mookiedog/ApriliaGen1ECU/ECU_s1.png

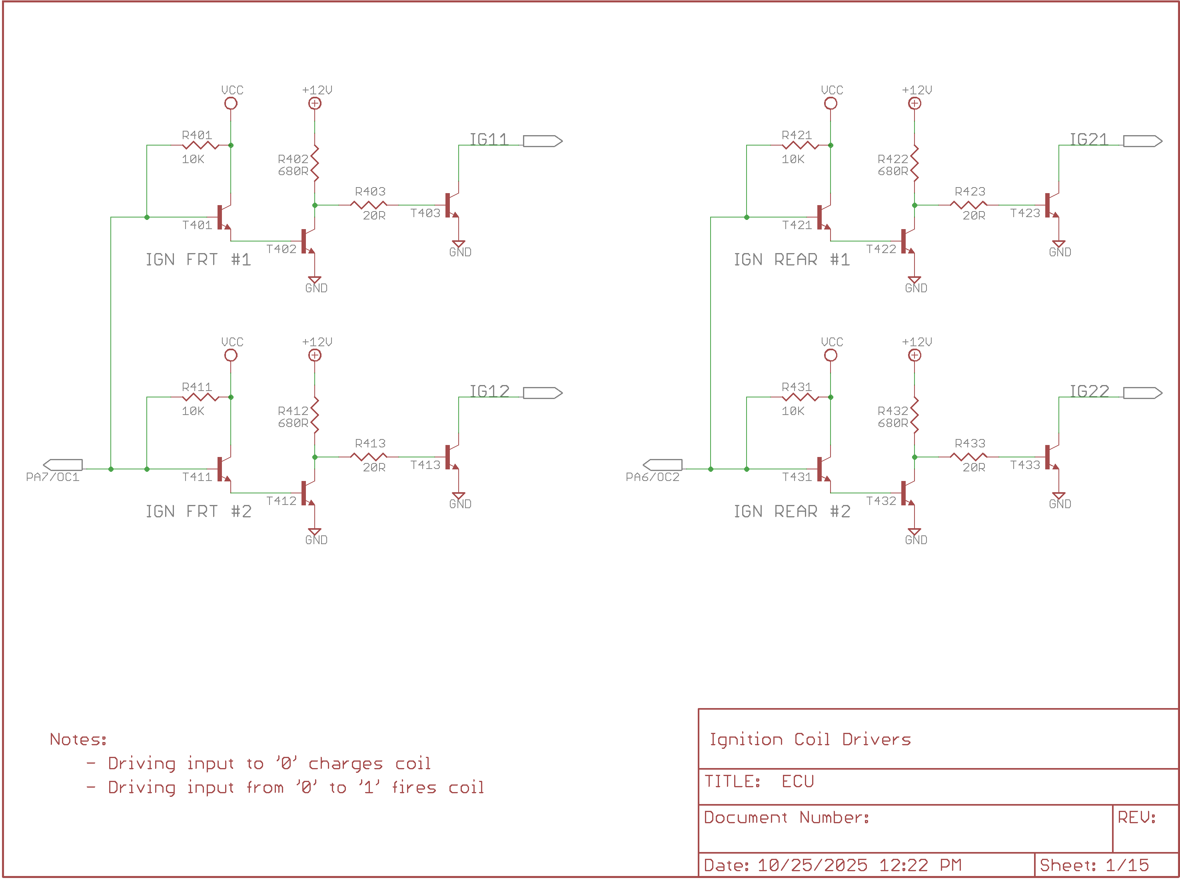
ECU_s1.png
