mookiedog/ApriliaGen1ECU/ECU_s2.png

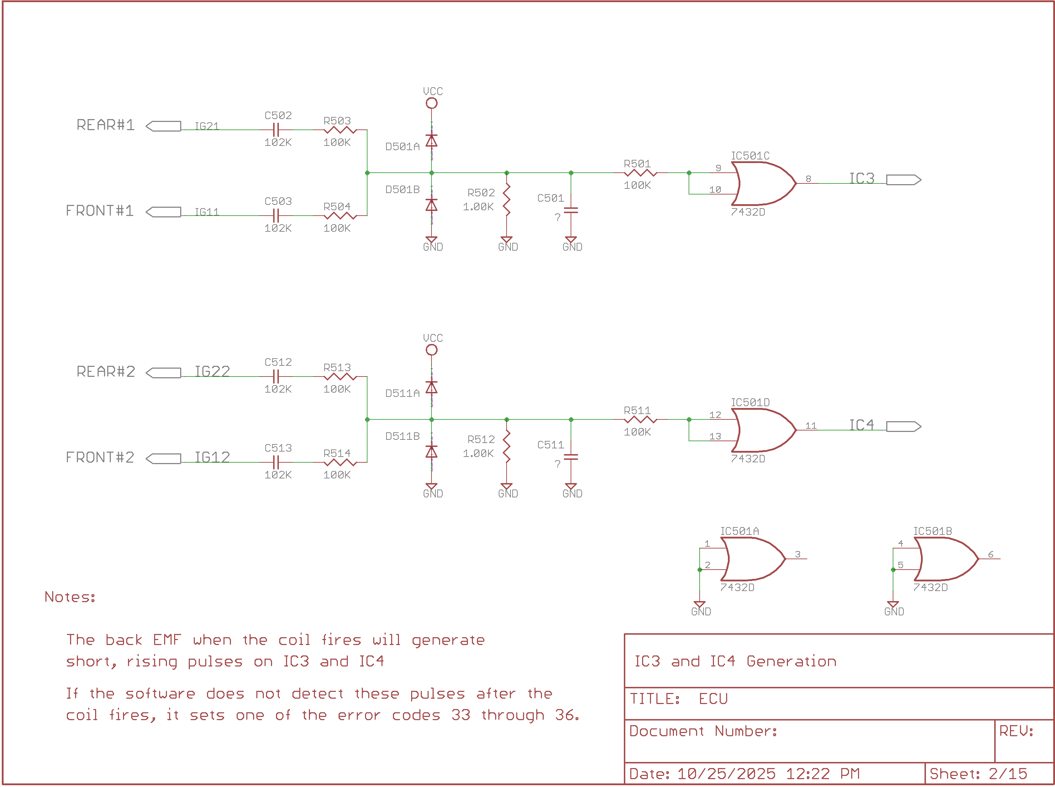
ECU_s2.png
