mookiedog/ApriliaGen1ECU/ECU_s3.png

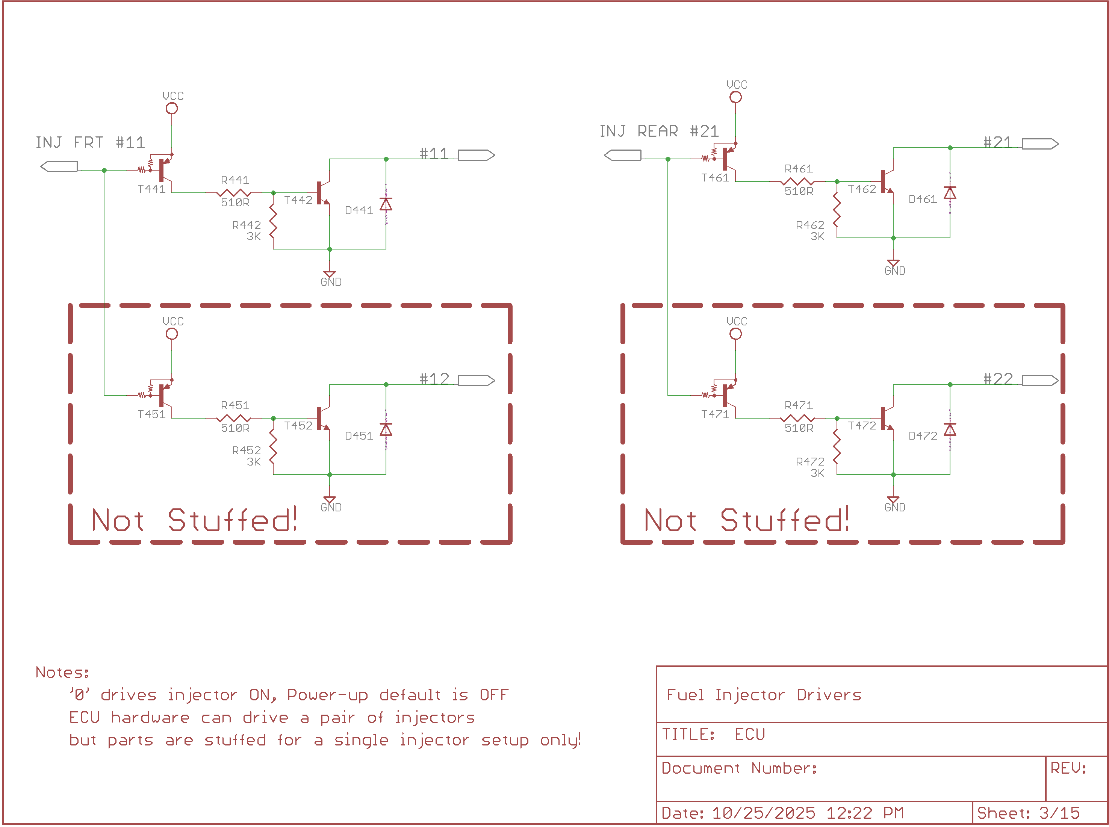
ECU_s3.png
