mookiedog/ApriliaGen1ECU/ECU_s4.png

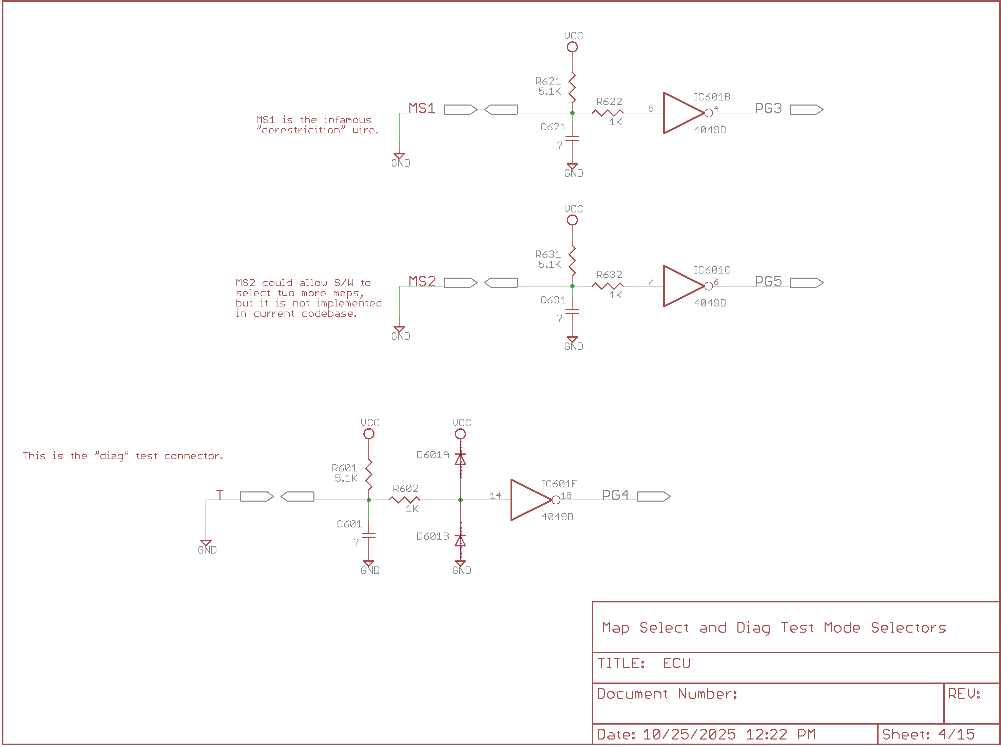
ECU_s4.png
