mookiedog/ApriliaGen1ECU/ECU_s5.png

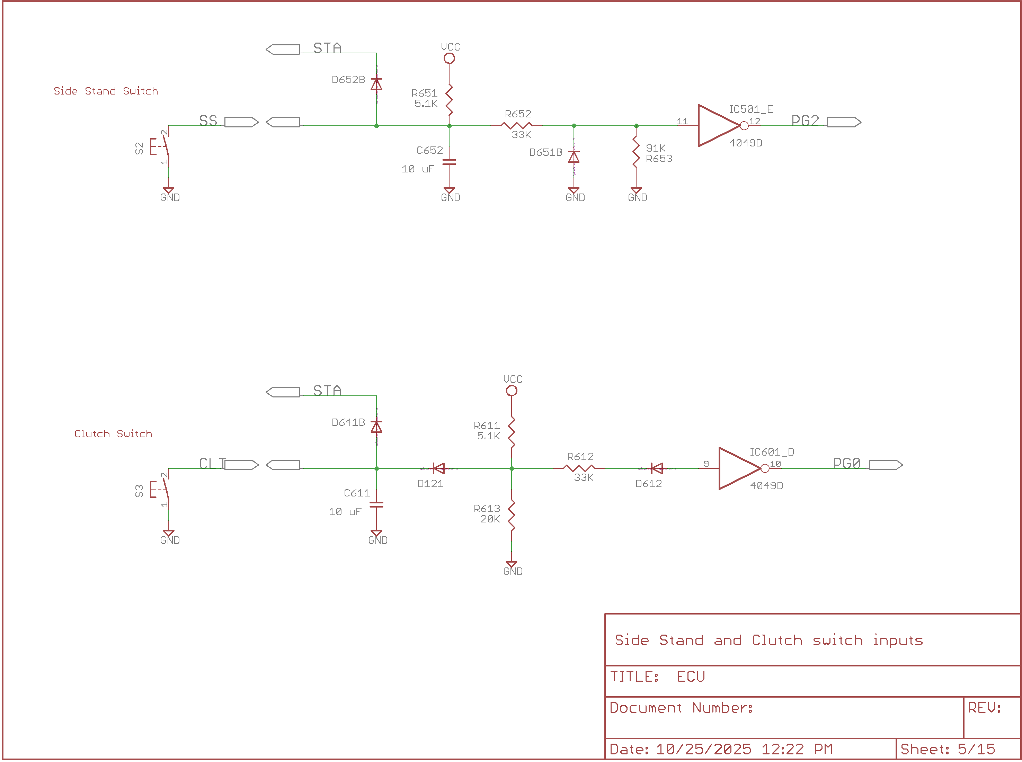
ECU_s5.png
