mookiedog/ApriliaGen1ECU/ECU_s6.png

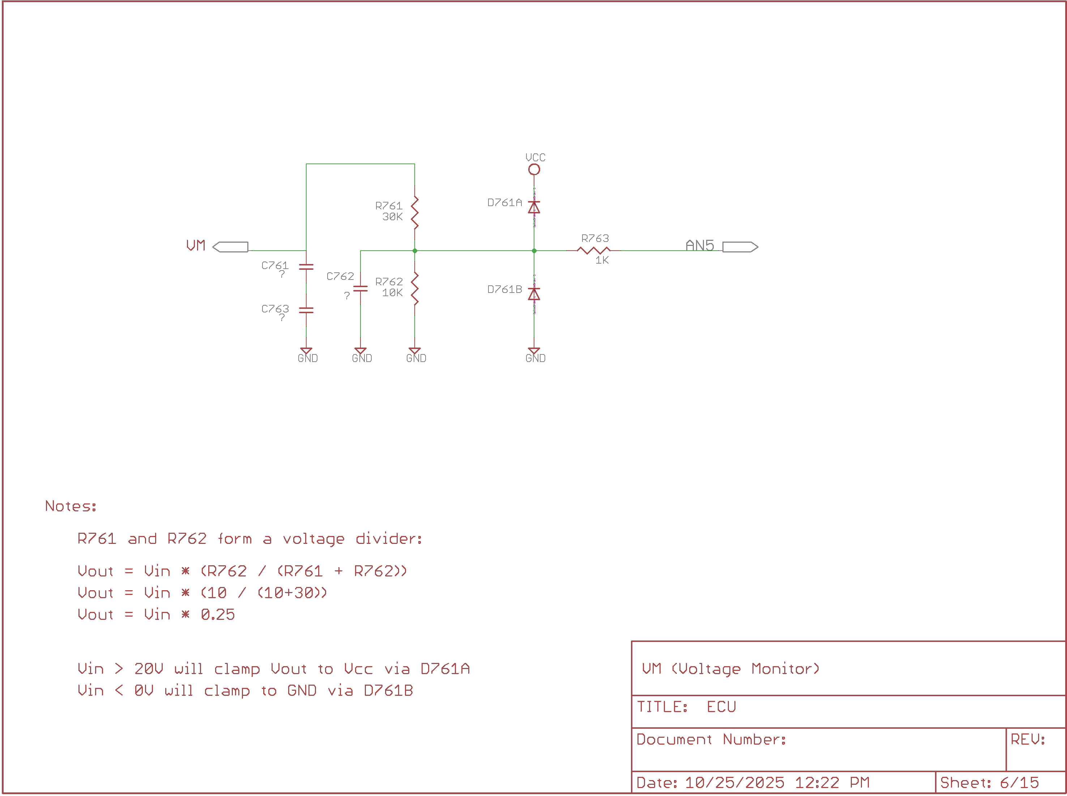
ECU_s6.png
