mookiedog/ApriliaGen1ECU/ECU_s7.png

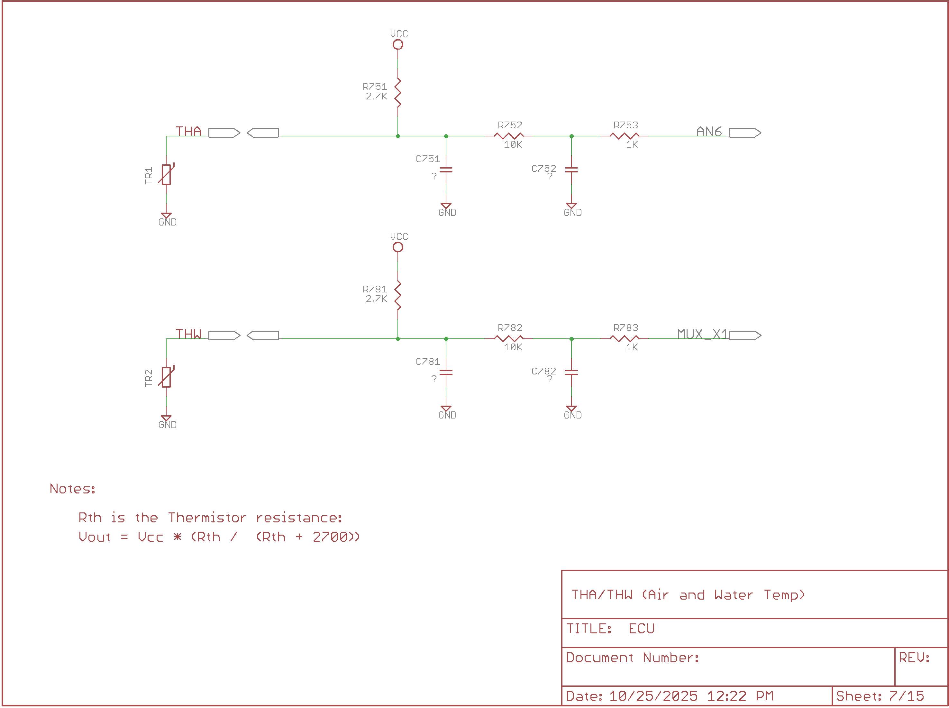
ECU_s7.png
