mookiedog/ApriliaGen1ECU/ECU_s8.png

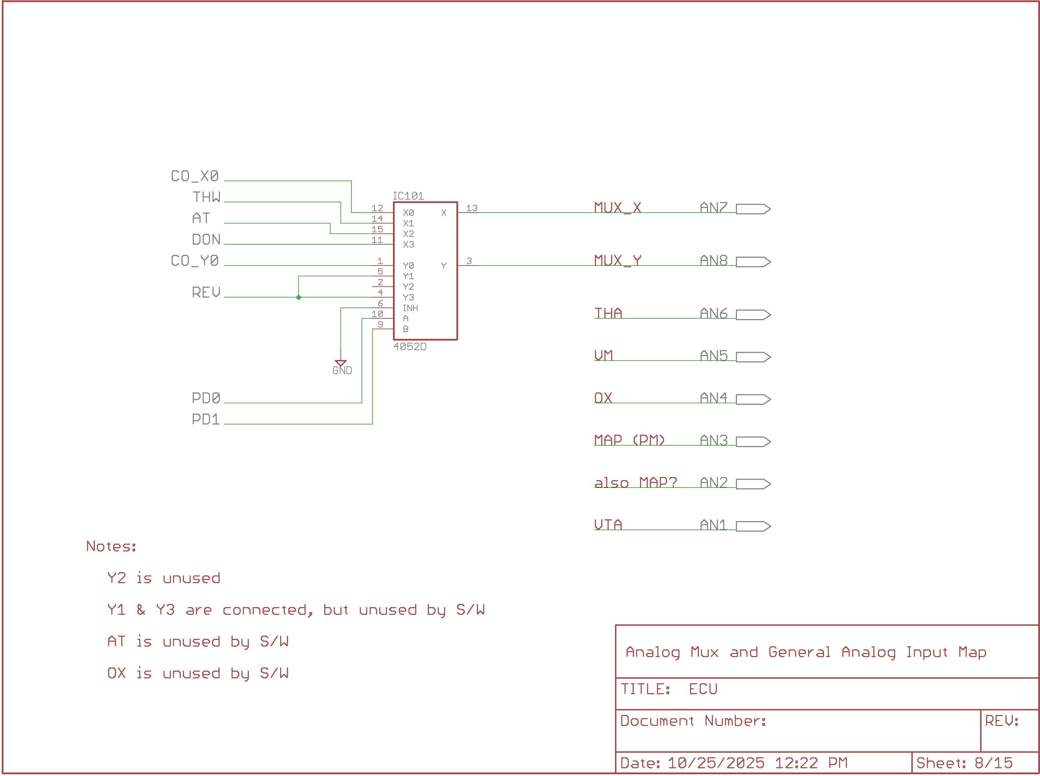
ECU_s8.png
