mookiedog/ApriliaGen1ECU/ECU_s9.png

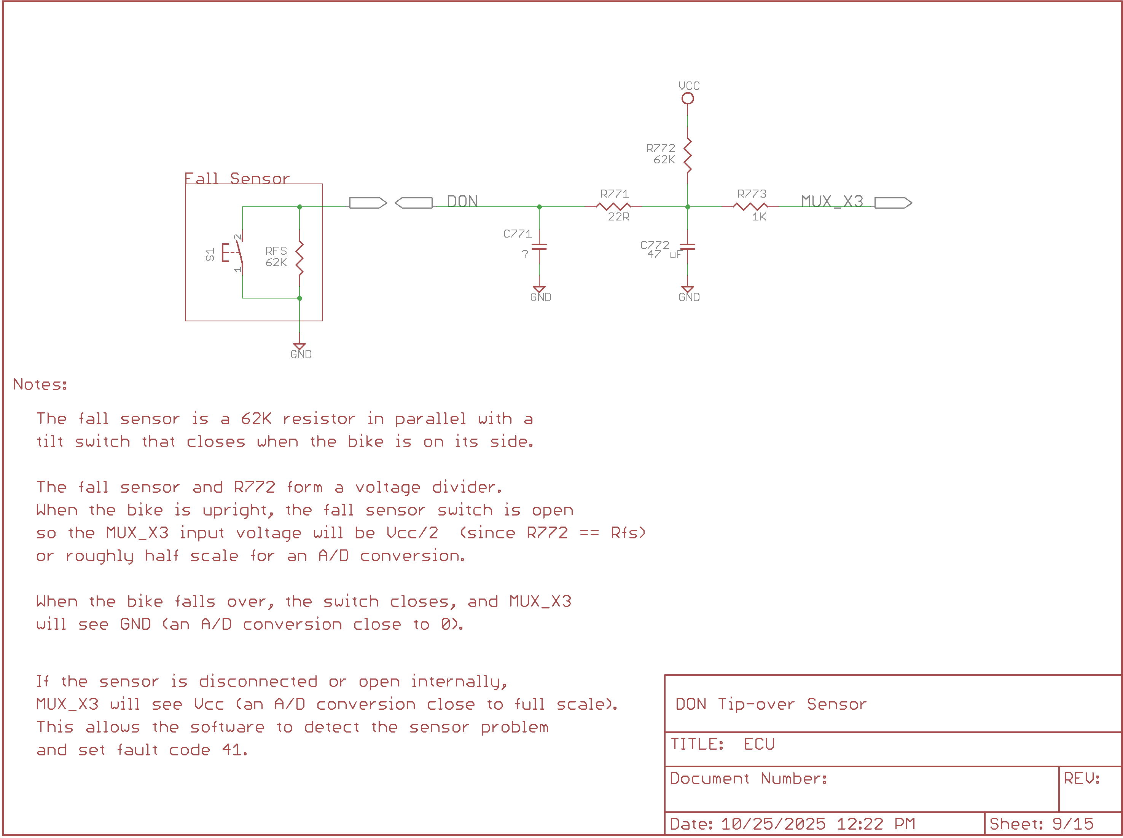
ECU_s9.png
