mookiedog/ApriliaGen1ECU/ECU_s10.png

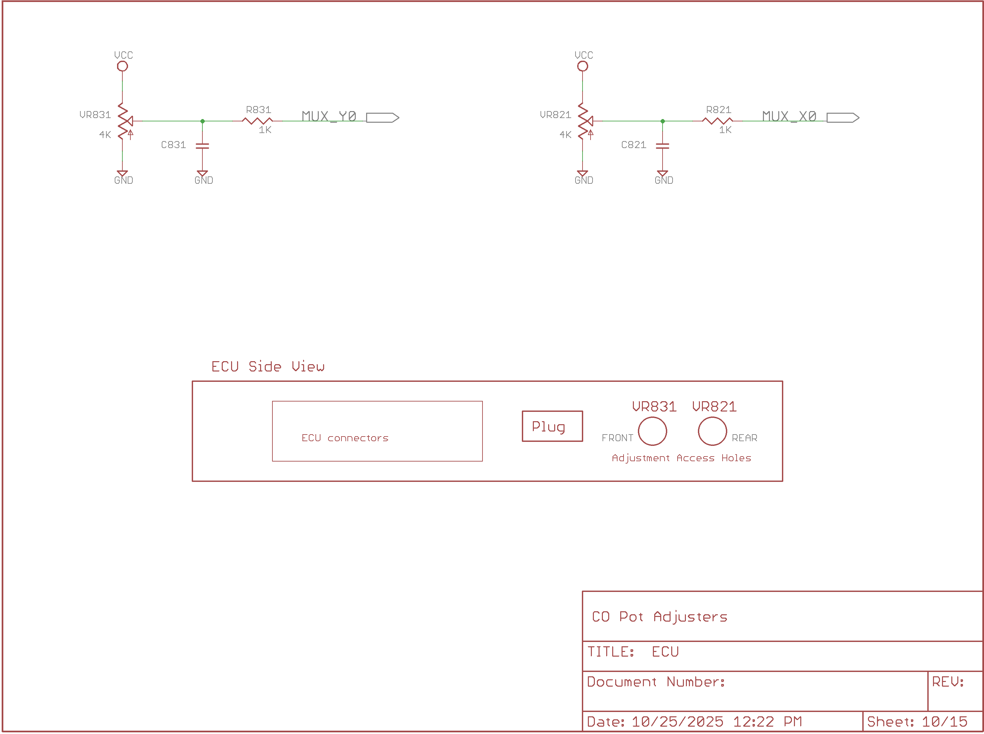
ECU_s10.png
