mookiedog/ApriliaGen1ECU/ECU_s11.png

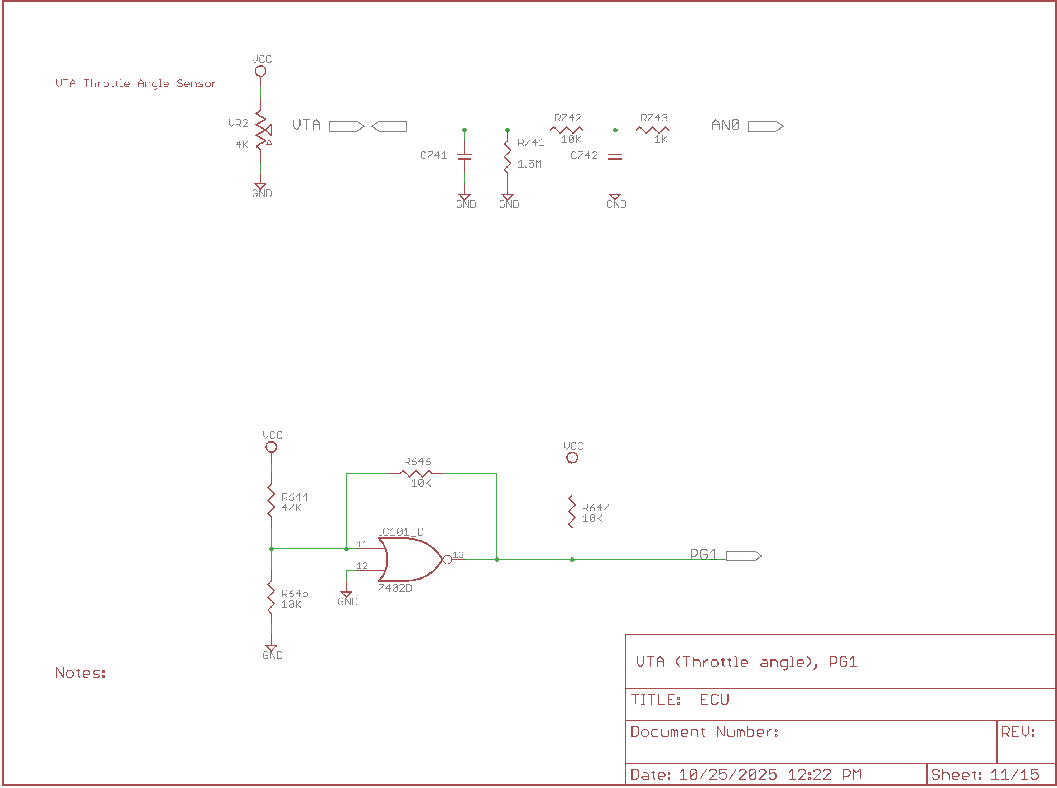
ECU_s11.png
