mookiedog/ApriliaGen1ECU/ECU_s12.png

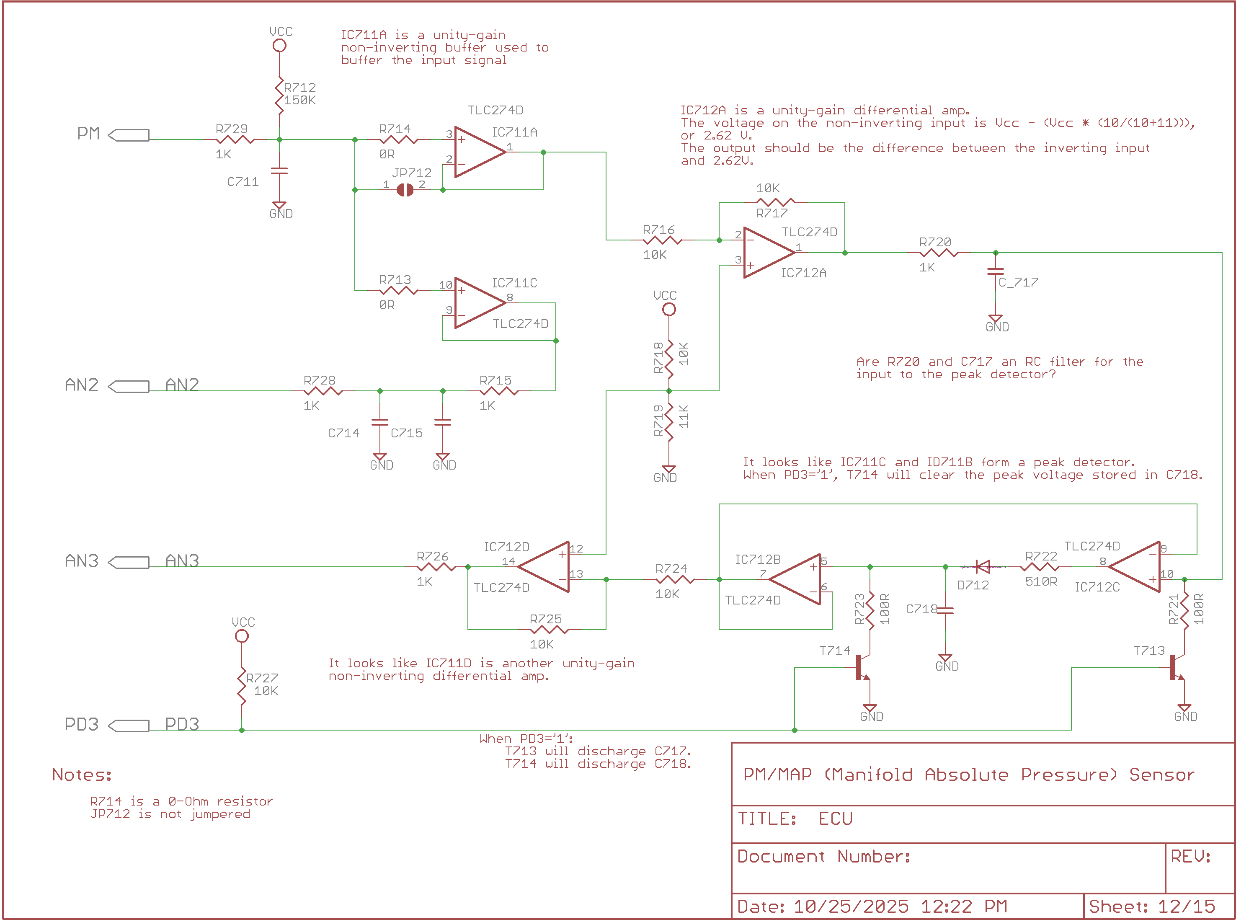
ECU_s12.png
