mookiedog/ApriliaGen1ECU/ECU_s13.png

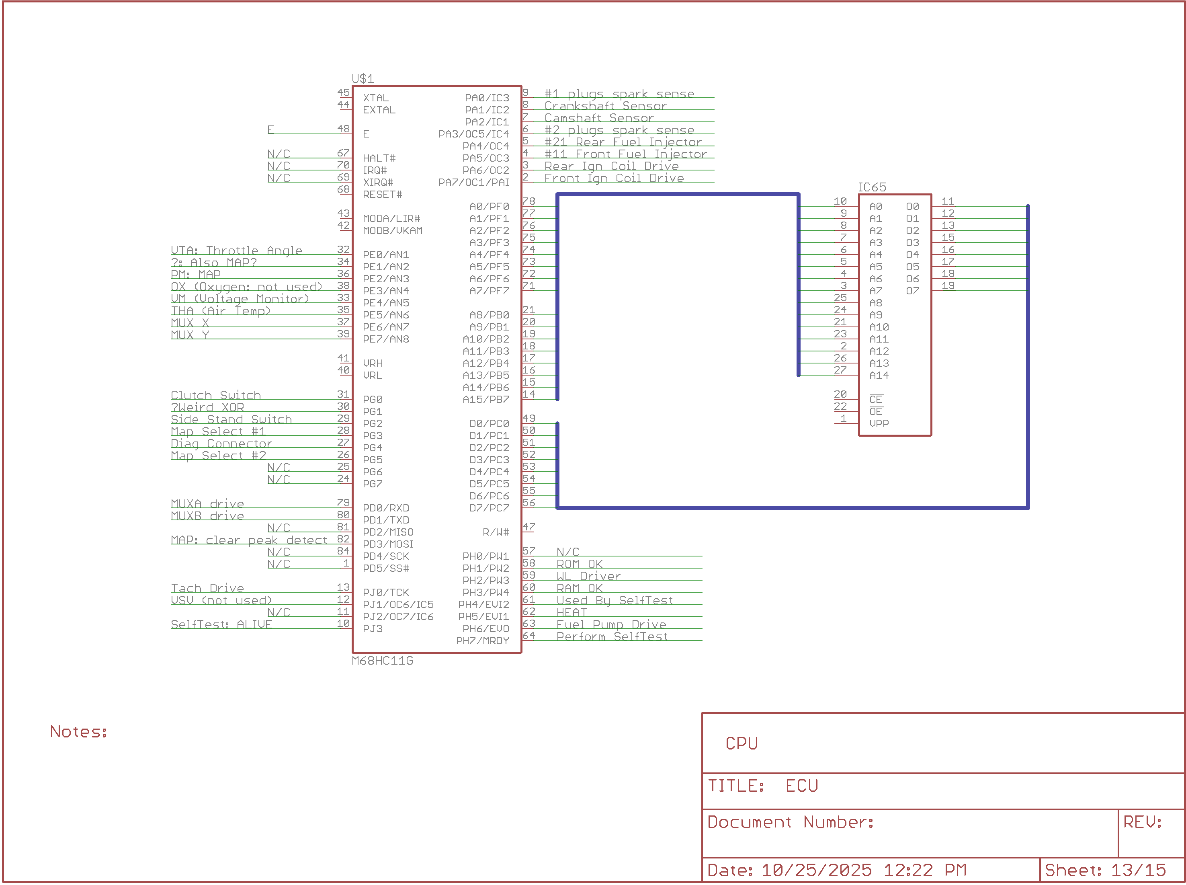
ECU_s13.png
