mookiedog/ApriliaGen1ECU/ECU_s14.png

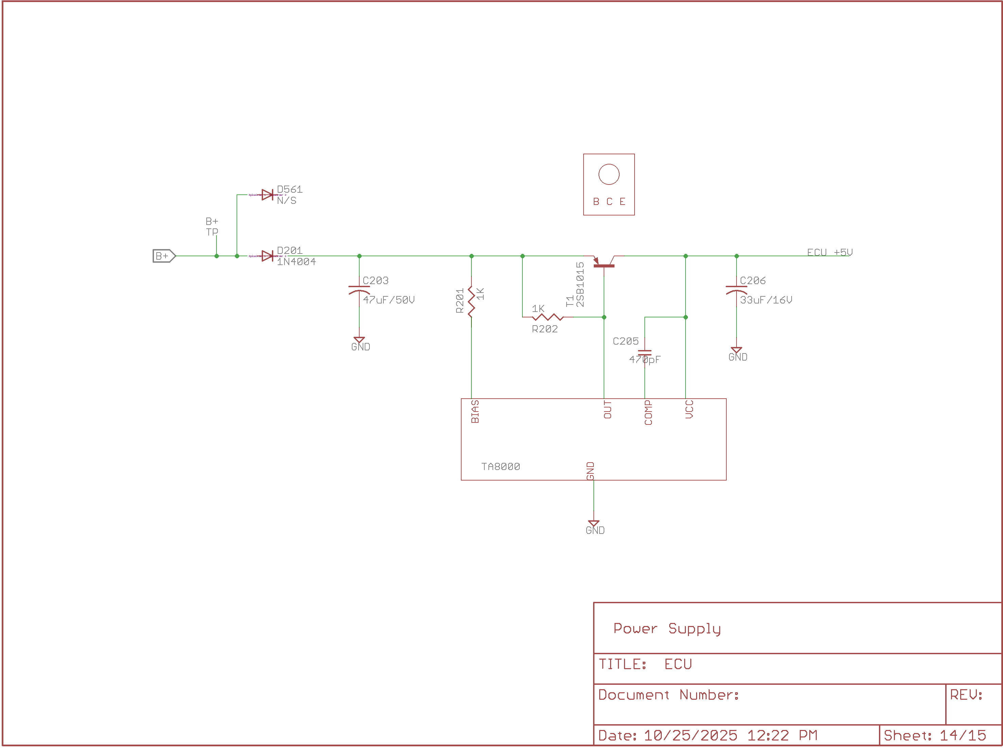
ECU_s14.png
