mookiedog/ApriliaGen1ECU/ECU_s15.png

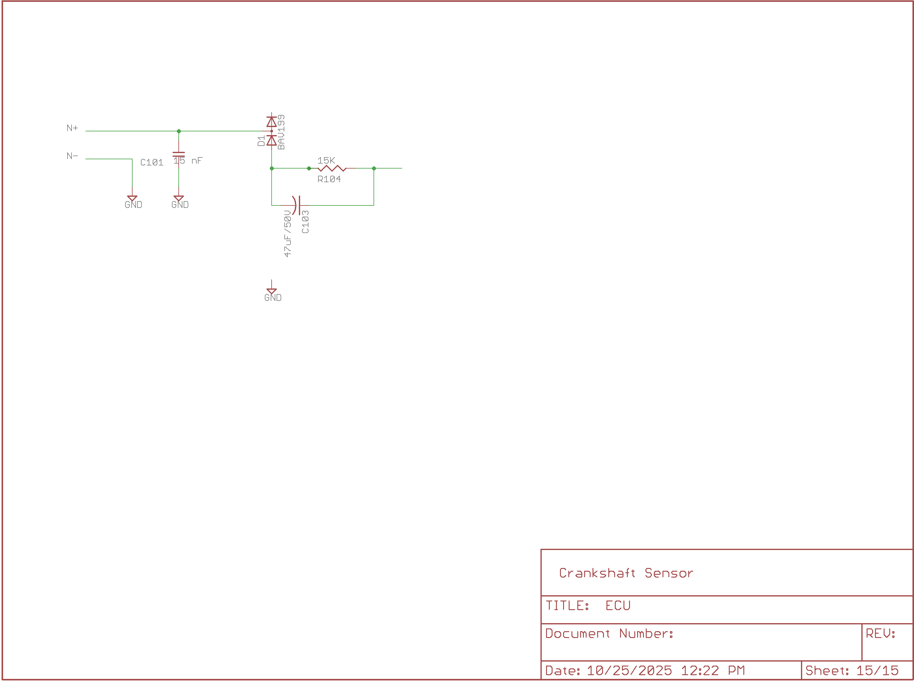
ECU_s15.png
