mookiedog/ApriliaGen1ECU/ECU.sch

## EAGLE design ECU.sch (2025-10-27)

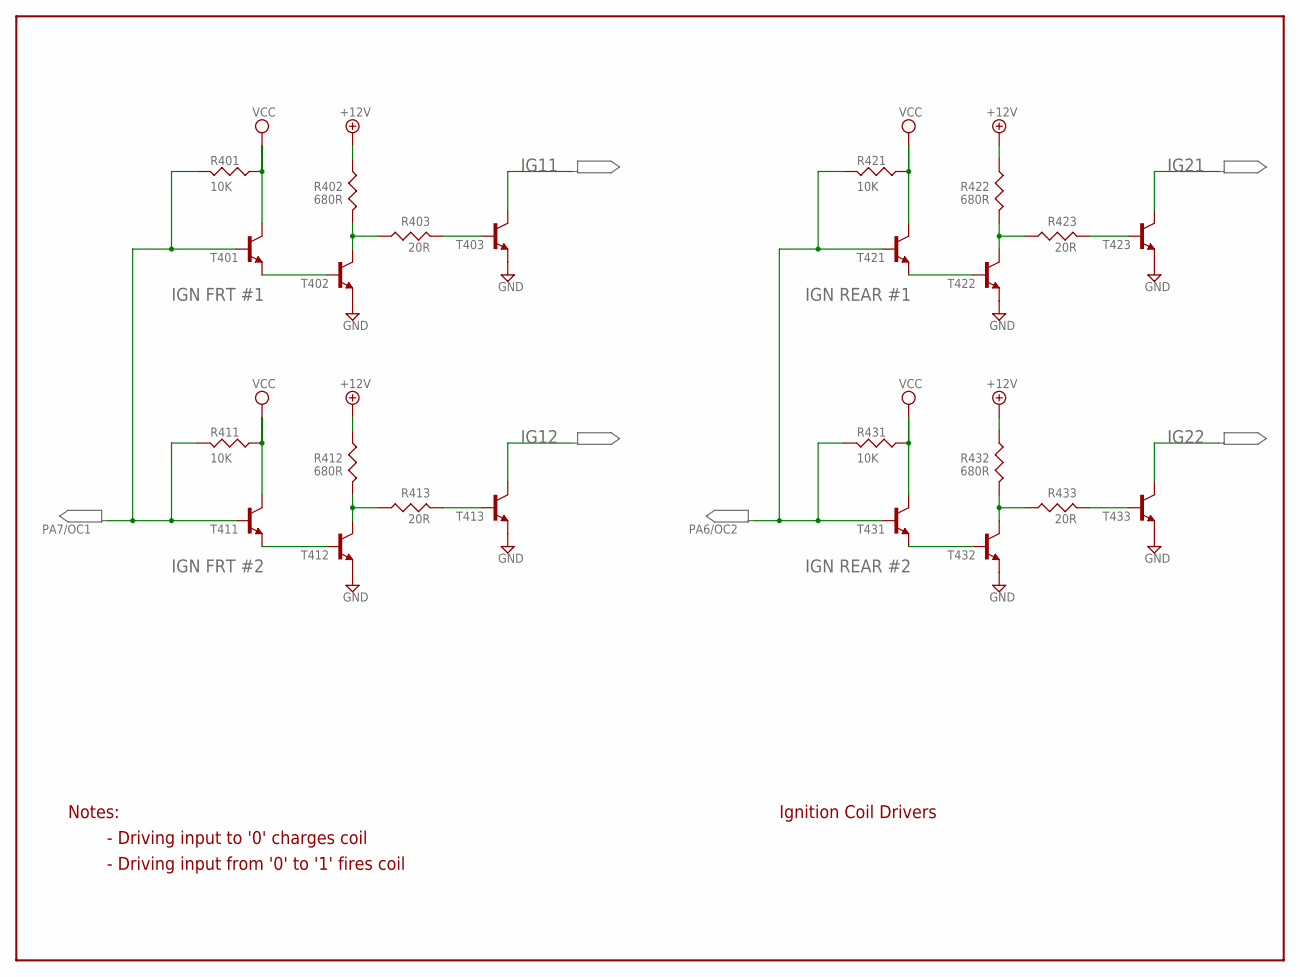
[picture p16: schematic ECU.sch, sheet 1]

Parts:
R401, R411, R421, R431: 10K; R-5
R402, R412, R422, R432: 680R; R-5
R403, R413, R423, R433: 20R; R-5
T401, T402, T403, T411, T412, T413, T421, T422, T423, T431, T432, T433: BCF32SMD; SOT23-BEC

Connections:
+12V: R402.1, R412.1, R422.1, R432.1
GND: T402.E, T403.E, T412.E, T413.E, T422.E, T423.E, T432.E, T433.E
IG11: T403.C
IG12: T413.C
IG21: T423.C
IG22: T433.C
unnamed: R402.2, R403.1, T402.C
unnamed: T401.E, T402.B
unnamed: R401.2, R411.2, T401.B, T411.B
unnamed: R403.2, T403.B
unnamed: T421.E, T422.B
unnamed: R422.2, R423.1, T422.C
unnamed: R423.2, T423.B
unnamed: R421.2, R431.2, T421.B, T431.B
unnamed: T411.E, T412.B
unnamed: R412.2, R413.1, T412.C
unnamed: R413.2, T413.B
unnamed: T431.E, T432.B
unnamed: R432.2, R433.1, T432.C
unnamed: R433.2, T433.B
VCC: R401.1, R411.1, R421.1, R431.1, T401.C, T411.C, T421.C, T431.C

Notes on the sheet:
Ignition Coil Drivers
IGN FRT #1
IGN REAR #1
IGN FRT #2
IGN REAR #2
Notes:
- Driving input to '0' charges coil
- Driving input from '0' to '1' fires coil
PA7/OC1
PA6/OC2

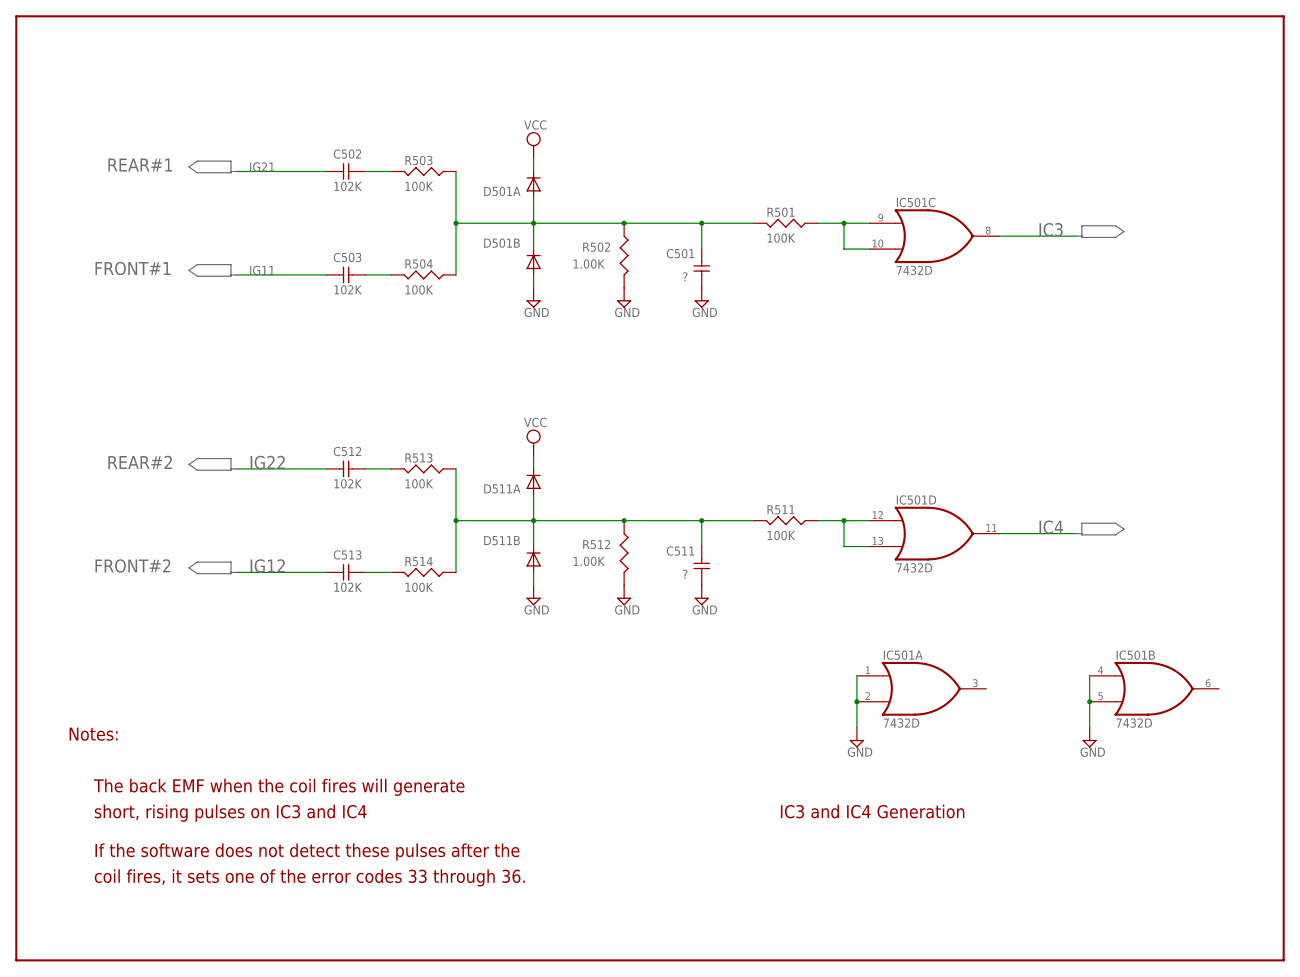
[picture p17: schematic ECU.sch, sheet 2]

Parts:
C501, C511: ?; C-2,5
C502, C503, C512, C513: 102K; C-2,5
D501A, D501B, D511A, D511B: 1N4004; DO41-10
IC501: 7432D; SO14
R501, R503, R504, R511, R513, R514: 100K; R-5
R502, R512: 1.00K; R-5

Connections:
GND: C501.1, C511.1, D501B.A, D511B.A, IC501.1 (I0), IC501.2 (I1), IC501.4 (I0), IC501.5 (I1), R502.2, R512.2
IC3: IC501.8 (O)
IC4: IC501.11 (O)
IG11: C503.1
IG12: C513.1
IG21: C502.1
IG22: C512.1
unnamed: C503.2, R504.2
unnamed: C501.2, D501A.A, D501B.C, R501.2, R502.1, R503.1, R504.1
unnamed: IC501.9 (I0), IC501.10 (I1), R501.1
unnamed: C502.2, R503.2
unnamed: C512.2, R513.2
unnamed: C513.2, R514.2
unnamed: C511.2, D511A.A, D511B.C, R511.2, R512.1, R513.1, R514.1
unnamed: IC501.12 (I0), IC501.13 (I1), R511.1
VCC: D501A.C, D511A.C

Notes on the sheet:
IC3 and IC4 Generation
FRONT#1
REAR#1
REAR#2
FRONT#2
The back EMF when the coil fires will generate
short, rising pulses on IC3 and IC4
Notes:
If the software does not detect these pulses after the
coil fires, it sets one of the error codes 33 through 36.

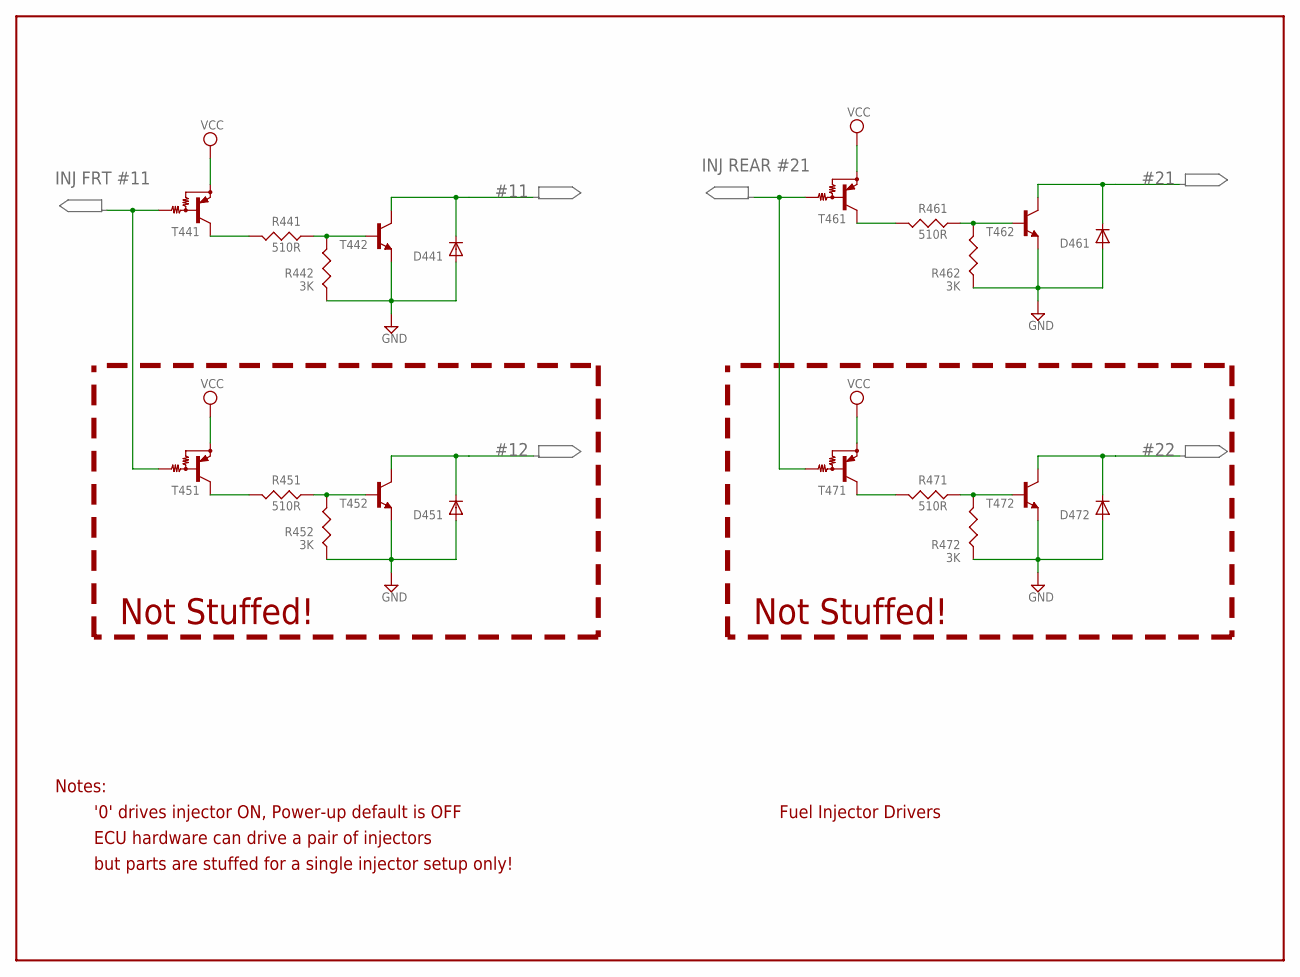
[picture p18: schematic ECU.sch, sheet 3]

Parts:
D441, D451, D461, D472: 1N4004; DO41-10
R441, R451, R461, R471: 510R; R-5
R442, R452, R462, R472: 3K; R-5
T441, T451, T461, T471: MUN2111T1-PNP_DRIVER-SC59-BEC; SC59-BEC
T442, T452, T462, T472: BCF32SMD; SOT23-BEC

Connections:
GND: D441.A, D451.A, D461.A, D472.A, R442.1, R452.1, R462.1, R472.1, T442.E, T452.E, T462.E, T472.E
unnamed: R441.2, T441.C
unnamed: D441.C, T442.C
unnamed: D461.C, T462.C
unnamed: D472.C, T472.C
unnamed: R461.2, T461.C
unnamed: R461.1, R462.2, T462.B
unnamed: D451.C, T452.C
unnamed: T441.B, T451.B
unnamed: R451.2, T451.C
unnamed: R451.1, R452.2, T452.B
unnamed: T461.B, T471.B
unnamed: R471.2, T471.C
unnamed: R471.1, R472.2, T472.B
unnamed: R441.1, R442.2, T442.B
VCC: T441.E, T451.E, T461.E, T471.E

Notes on the sheet:
Fuel Injector Drivers
INJ FRT #11
INJ REAR #21
Not Stuffed!
Notes:
ECU hardware can drive a pair of injectors
but parts are stuffed for a single injector setup only!
'0' drives injector ON, Power-up default is OFF

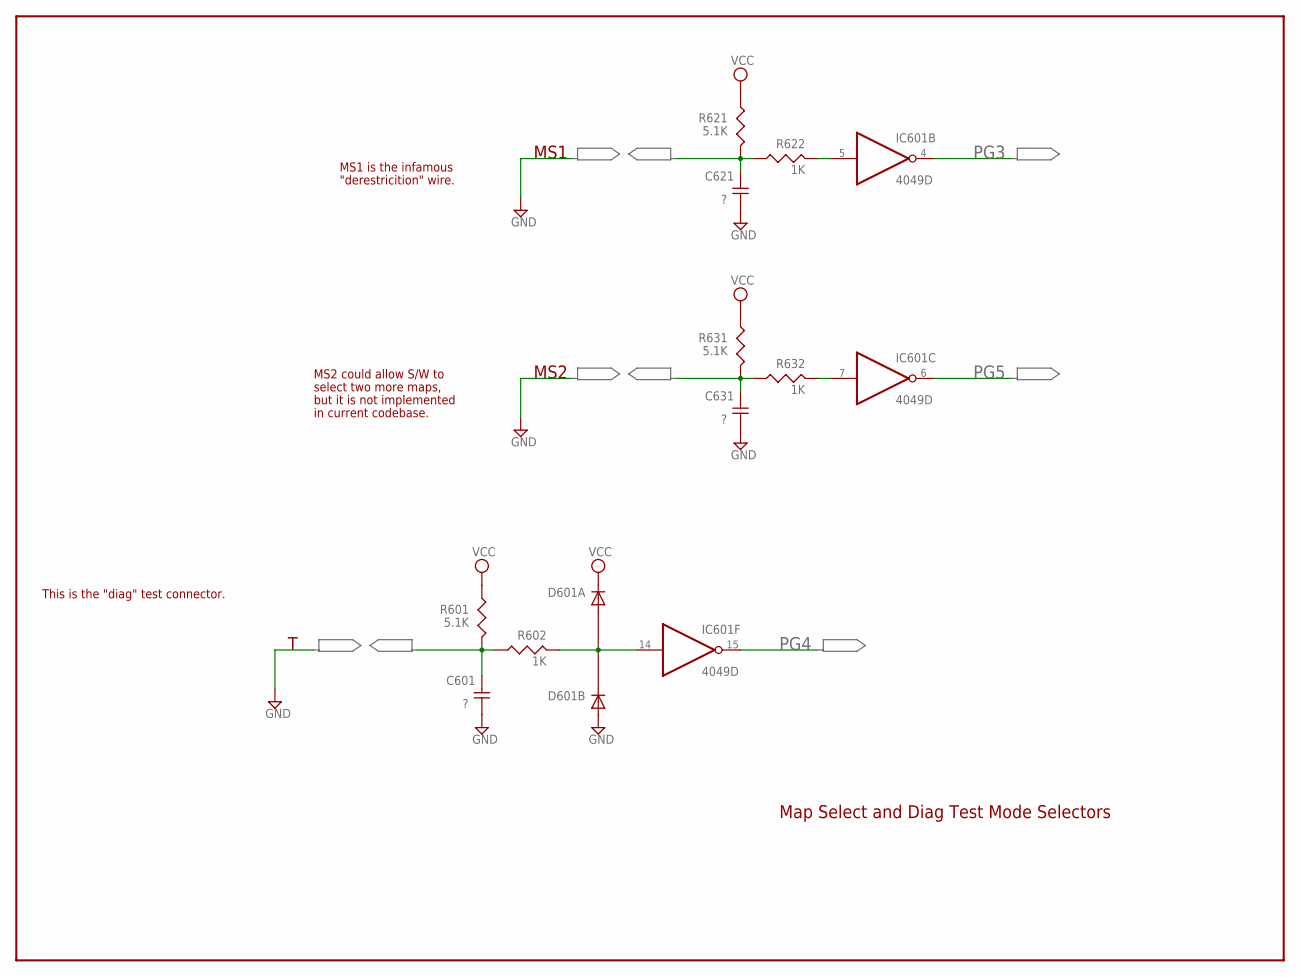
[picture p19: schematic ECU.sch, sheet 4]

Parts:
C601, C621, C631: ?; C-2,5
D601A, D601B: 1N4004; DO41-10
IC601: 4049D; SO16
R601, R621, R631: 5.1K; R-5
R602, R622, R632: 1K; R-5

Connections:
GND: C601.1, C621.1, C631.1, D601B.A
unnamed: C621.2, R621.2, R622.1
unnamed: IC601.5 (I), R622.2
unnamed: C631.2, R631.2, R632.1
unnamed: IC601.7 (I), R632.2
unnamed: C601.2, R601.2, R602.1
unnamed: IC601.14 (I), R602.2
PG3: IC601.4 (O)
PG4: IC601.15 (O)
PG5: IC601.6 (O)
VCC: D601A.C, R601.1, R621.1, R631.1

Notes on the sheet:
Map Select and Diag Test Mode Selectors
MS1
MS2
MS1 is the infamous
"derestricition" wire.
MS2 could allow S/W to
select two more maps,
but it is not implemented
in current codebase.
This is the "diag" test connector.

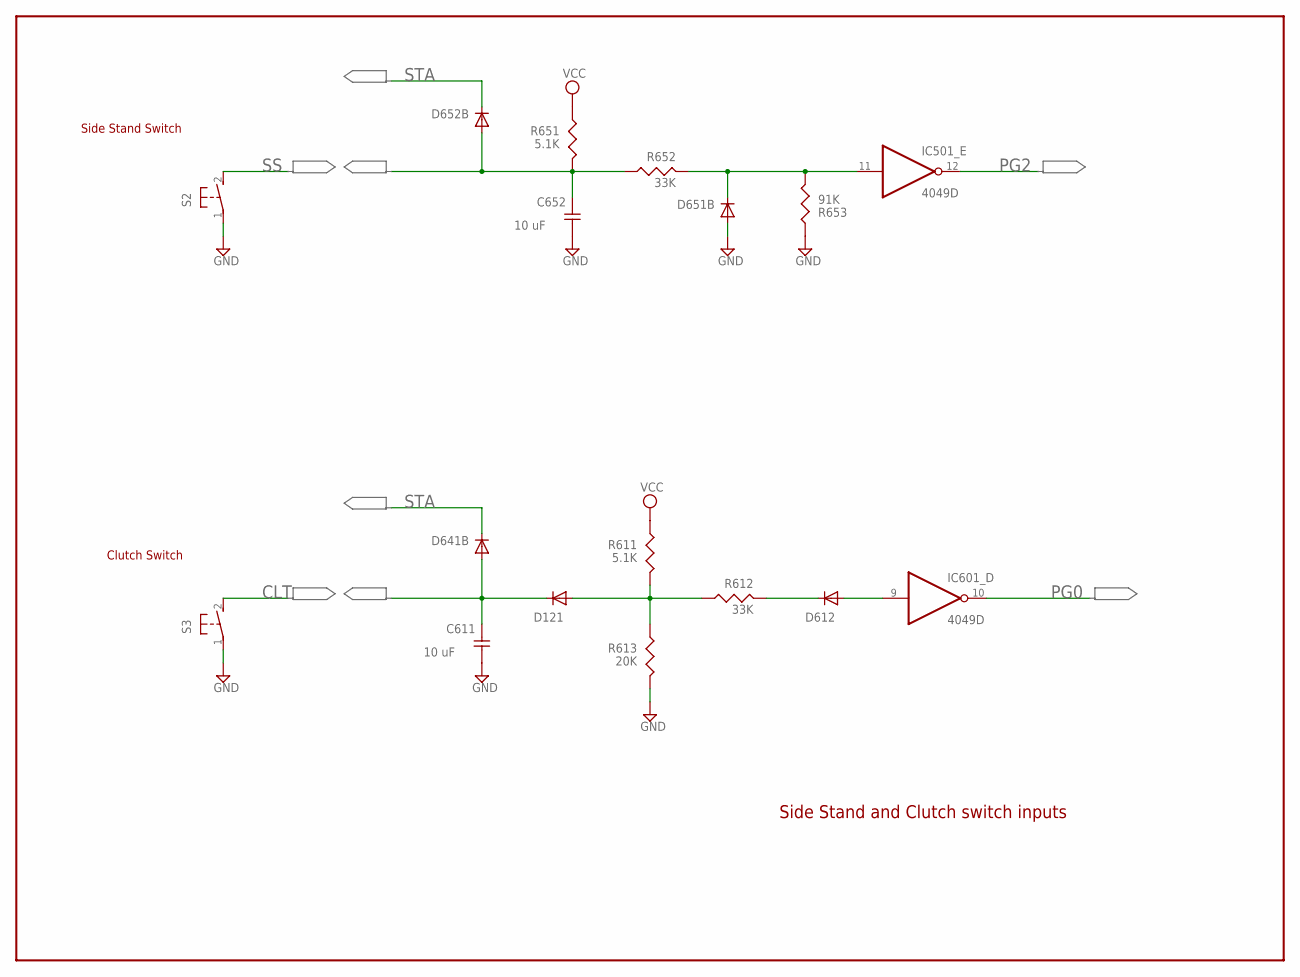
[picture p20: schematic ECU.sch, sheet 5]

Parts:
C611, C652: 10 uF; C-2,5
D121, D612, D641B, D651B, D652B: 1N4004; DO41-10
IC501_, IC601_: 4049D; SO16
R611, R651: 5.1K; R-5
R612, R652: 33K; R-5
R613: 20K; R-5
R653: 91K; R-5
S2, S3: 31-XX; B3F-31XX

Connections:
CLT: S3.2 (S)
GND: C611.1, C652.1, D651B.A, R613.2, R653.1, S2.1, S3.1
unnamed: C652.2, D652B.A, R651.2, R652.1
unnamed: D651B.C, IC501_.11 (I), R652.2, R653.2
unnamed: C611.2, D121.C, D641B.A
unnamed: D612.C, R612.2
unnamed: D612.A, IC601_.9 (I)
unnamed: D121.A, R611.2, R612.1, R613.1
PG0: IC601_.10 (O)
PG2: IC501_.12 (O)
SS: S2.2 (S)
STA: D641B.C, D652B.C
VCC: R611.1, R651.1

Notes on the sheet:
Side Stand and Clutch switch inputs
Side Stand Switch
Clutch Switch

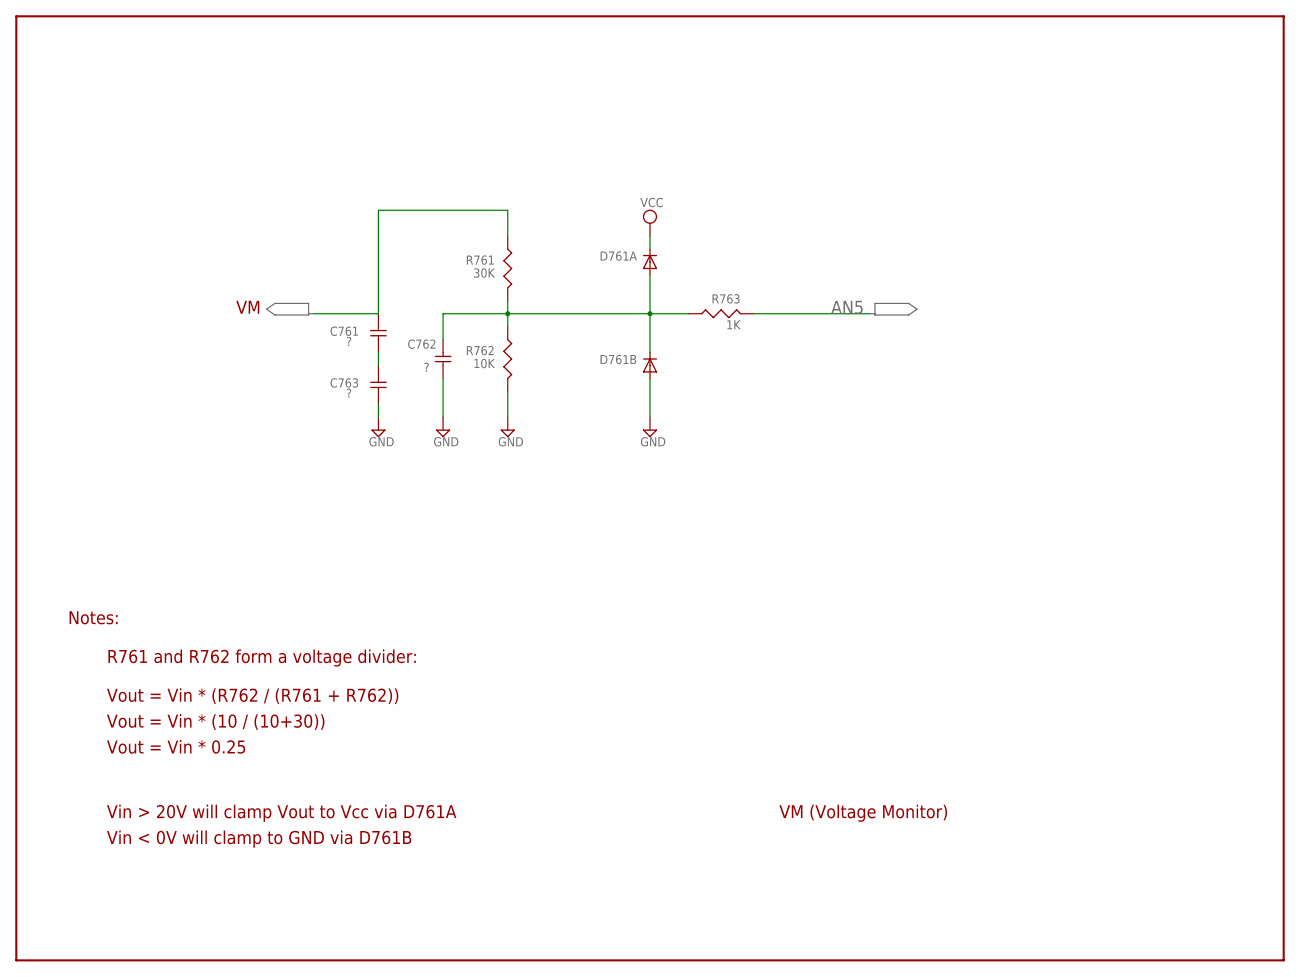
[picture p21: schematic ECU.sch, sheet 6]

Parts:
C761, C762, C763: ?; C-2,5
D761A, D761B: 1N4004; DO41-10
R761: 30K; R-5
R762: 10K; R-5
R763: 1K; R-5

Connections:
AN5: R763.2
GND: C762.1, C763.1, D761B.A, R762.2
unnamed: C761.1, C763.2
unnamed: C762.2, D761A.A, D761B.C, R761.2, R762.1, R763.1
unnamed: C761.2, R761.1
VCC: D761A.C

Notes on the sheet:
VM (Voltage Monitor)
Notes:
R761 and R762 form a voltage divider:
Vout = Vin * (R762 / (R761 + R762))
Vout = Vin * (10 / (10+30))
Vout = Vin * 0.25
Vin > 20V will clamp Vout to Vcc via D761A
Vin < 0V will clamp to GND via D761B

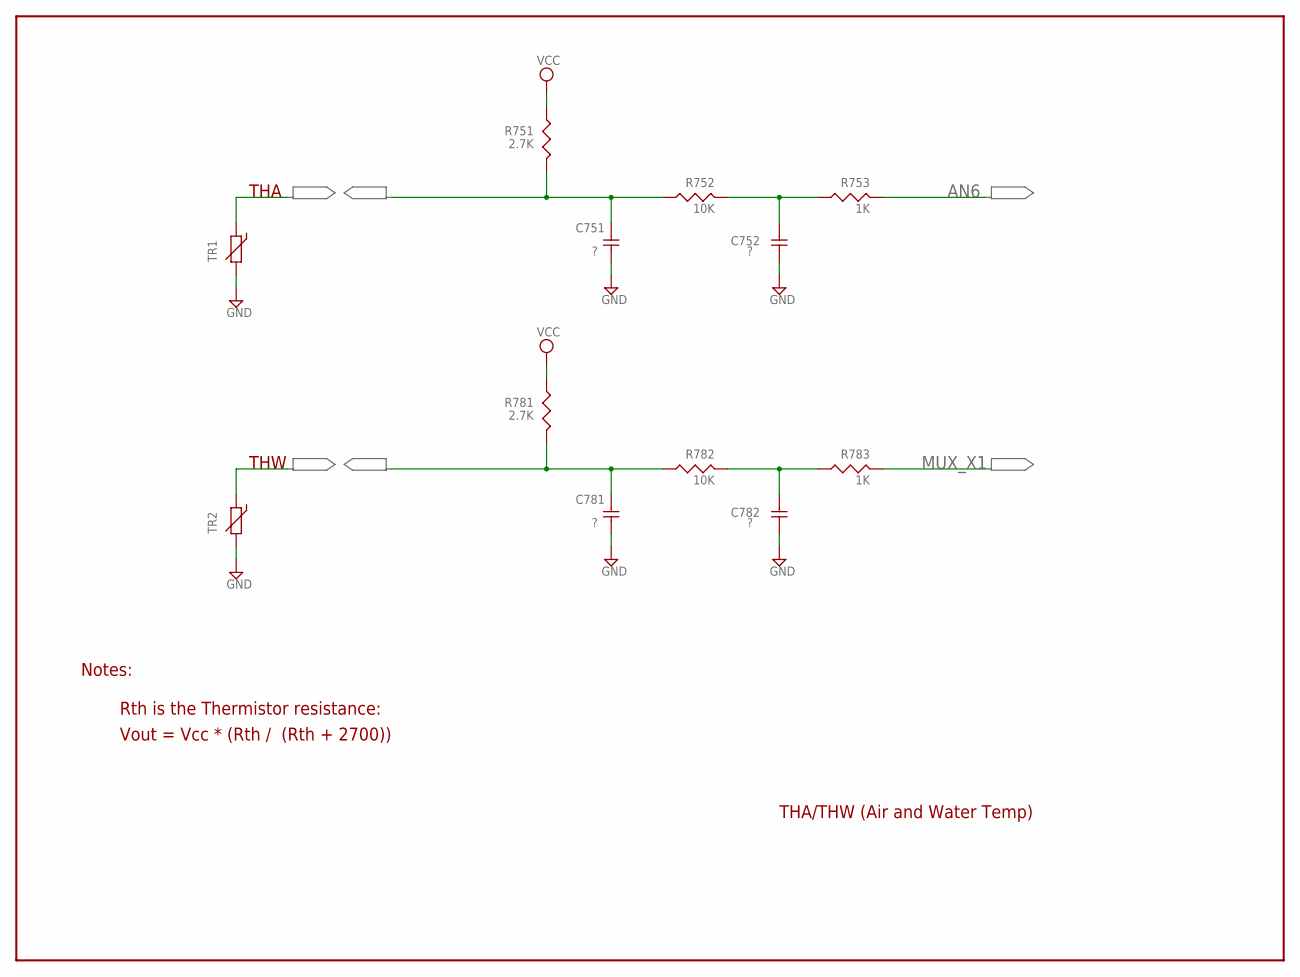
[picture p22: schematic ECU.sch, sheet 7]

Parts:
C751, C752, C781, C782: ?; C-2,5
R751, R781: 2.7K; R-5
R752, R782: 10K; R-5
R753, R783: 1K; R-5
TR1, TR2: THERM-5; R-5

Connections:
AN6: R753.2
GND: C751.1, C752.1, C781.1, C782.1, TR1.2, TR2.2
MUX_X1: R783.2
unnamed: C751.2, R751.2, R752.1
unnamed: C752.2, R752.2, R753.1
unnamed: C781.2, R781.2, R782.1
unnamed: C782.2, R782.2, R783.1
VCC: R751.1, R781.1

Notes on the sheet:
THA/THW (Air and Water Temp)
Notes:
THA
THW
Vout = Vcc * (Rth / (Rth + 2700))
Rth is the Thermistor resistance:

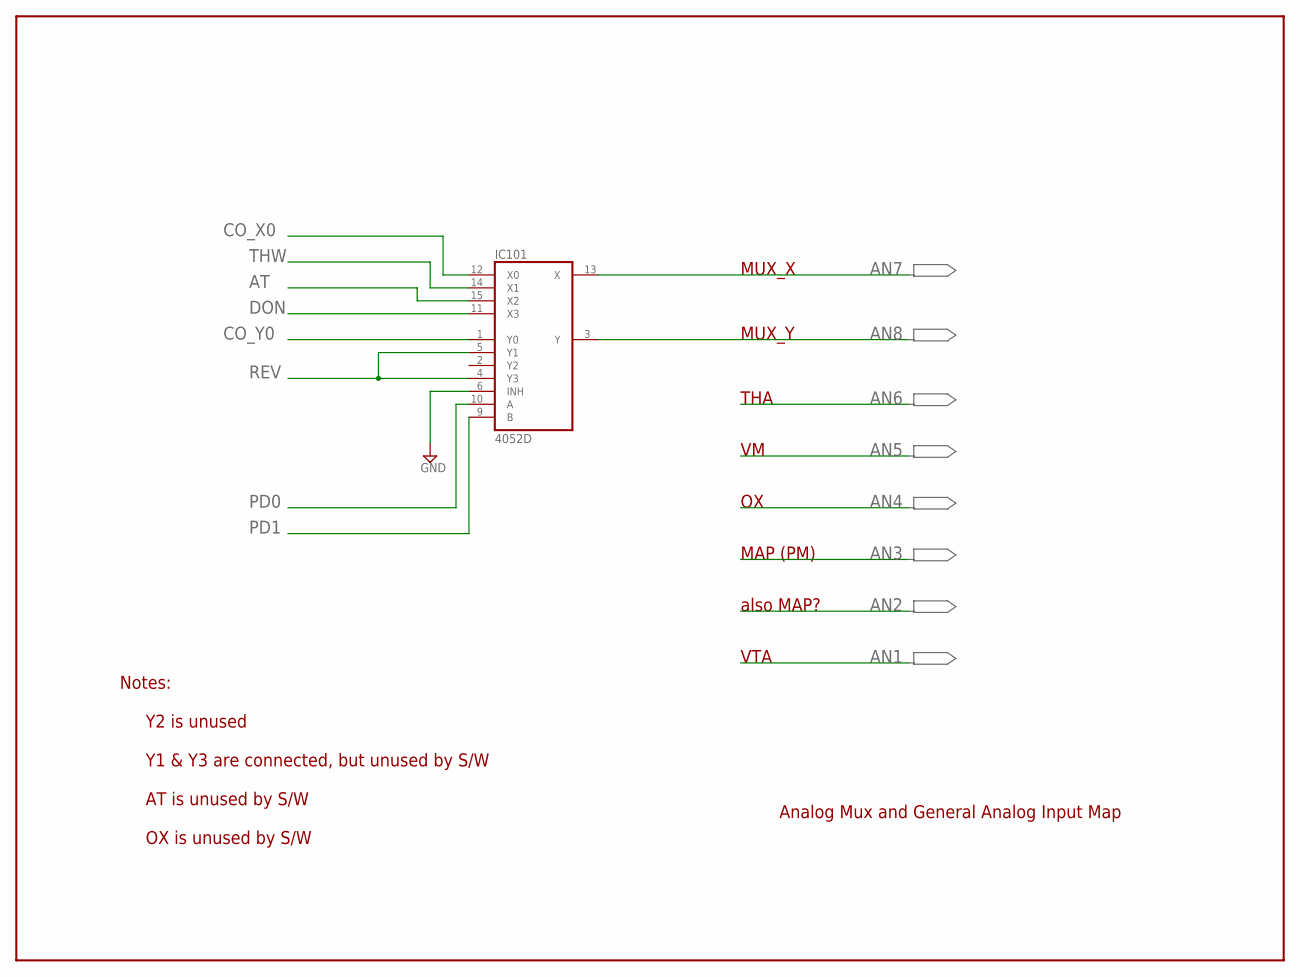
[picture p23: schematic ECU.sch, sheet 8]

Parts:
IC101: 4052D; SO16

Connections:
AN7: IC101.13 (X)
AN8: IC101.3 (Y)
AT: IC101.15 (X2)
CO_X0: IC101.12 (X0)
CO_Y0: IC101.1 (Y0)
DON: IC101.11 (X3)
GND: IC101.6 (INH)
PD0: IC101.10 (A)
PD1: IC101.9 (B)
REV: IC101.4 (Y3), IC101.5 (Y1)
THW: IC101.14 (X1)

Notes on the sheet:
Analog Mux and General Analog Input Map
Y2 is unused
THA
MAP (PM)
also MAP?
VTA
MUX_X
MUX_Y
Notes:
Y1 & Y3 are connected, but unused by S/W
AT is unused by S/W
OX is unused by S/W

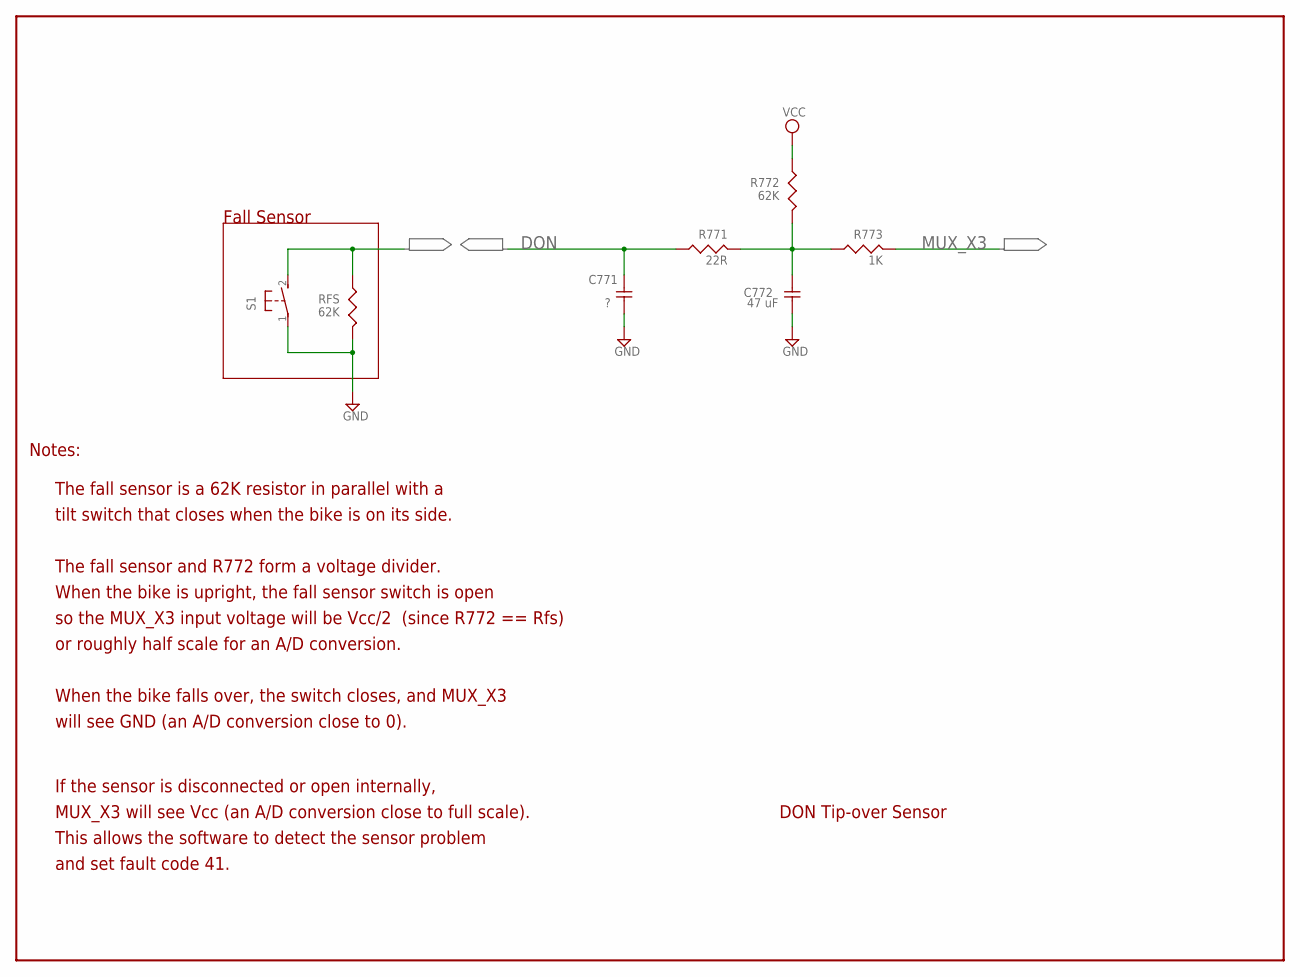
[picture p24: schematic ECU.sch, sheet 9]

Parts:
C771: ?; C-2,5
C772: 47 uF; C-2,5
R771: 22R; R-5
R772: 62K; R-5
R773: 1K; R-5
RFS: 62K; R-5
S1: 31-XX; B3F-31XX

Connections:
GND: C771.1, C772.1, RFS.2, S1.1
MUX_X3: R773.2
unnamed: C771.2, R771.1
unnamed: C772.2, R771.2, R772.2, R773.1
unnamed: RFS.1, S1.2 (S)
VCC: R772.1

Notes on the sheet:
DON Tip-over Sensor
Notes:
DON
Fall Sensor
The fall sensor is a 62K resistor in parallel with a
tilt switch that closes when the bike is on its side.
The fall sensor and R772 form a voltage divider.
When the bike is upright, the fall sensor switch is open
so the MUX_X3 input voltage will be Vcc/2 (since R772 == Rfs)
or roughly half scale for an A/D conversion.
When the bike falls over, the switch closes, and MUX_X3
will see GND (an A/D conversion close to 0).
If the sensor is disconnected or open internally,
MUX_X3 will see Vcc (an A/D conversion close to full scale).
This allows the software to detect the sensor problem
and set fault code 41.

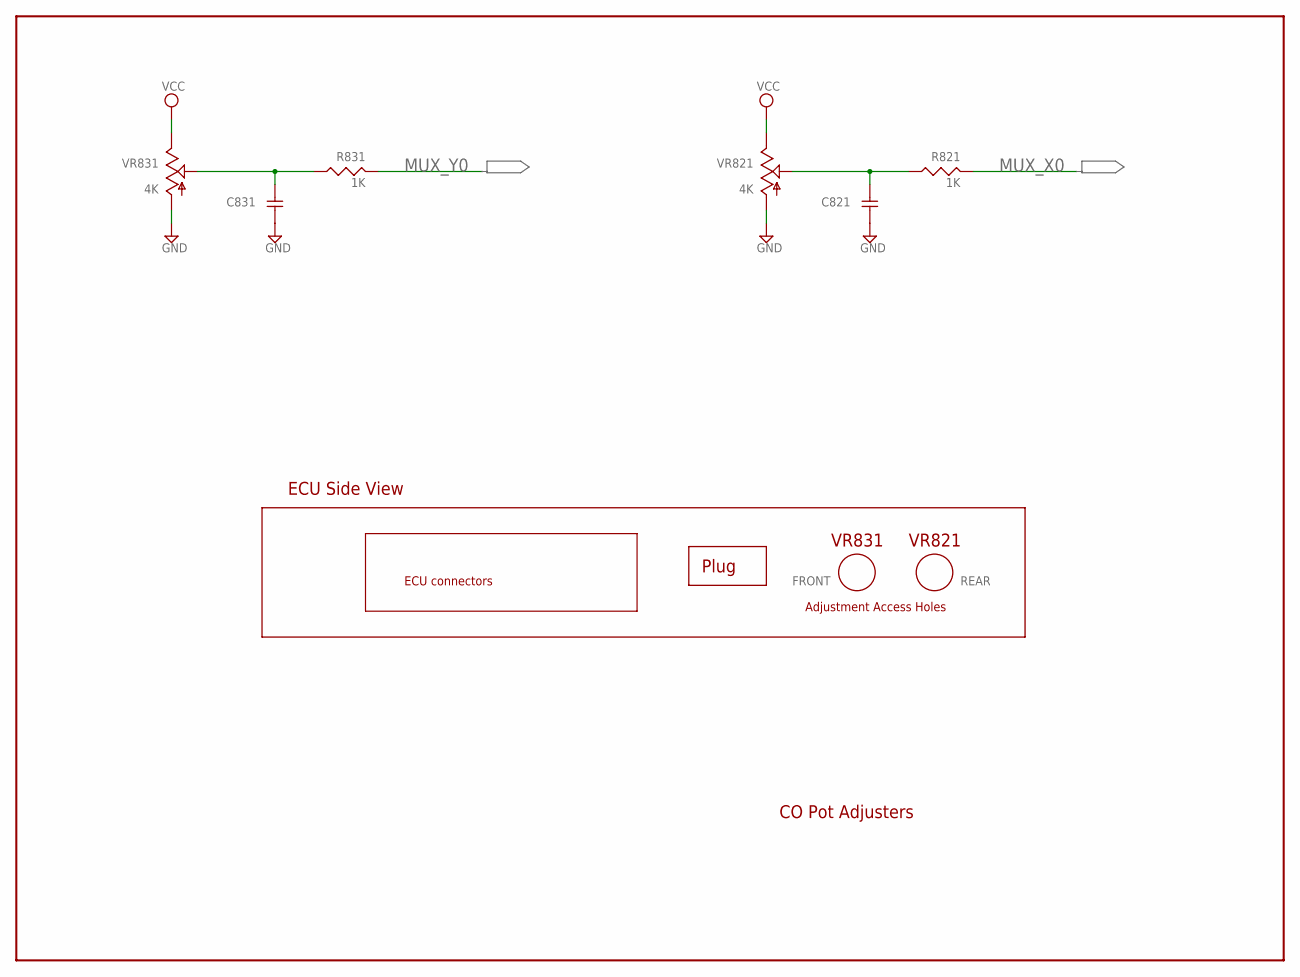
[picture p25: schematic ECU.sch, sheet 10]

Parts:
C821, C831: C-2,5
R821, R831: 1K; R-5
VR821, VR831: 4K; B25V

Connections:
GND: C821.1, C831.1, VR821.A, VR831.A
MUX_X0: R821.2
MUX_Y0: R831.2
unnamed: C821.2, R821.1, VR821.S
unnamed: C831.2, R831.1, VR831.S
VCC: VR821.E, VR831.E

Notes on the sheet:
CO Pot Adjusters
ECU Side View
Plug
VR831
VR821
Adjustment Access Holes
ECU connectors
FRONT
REAR

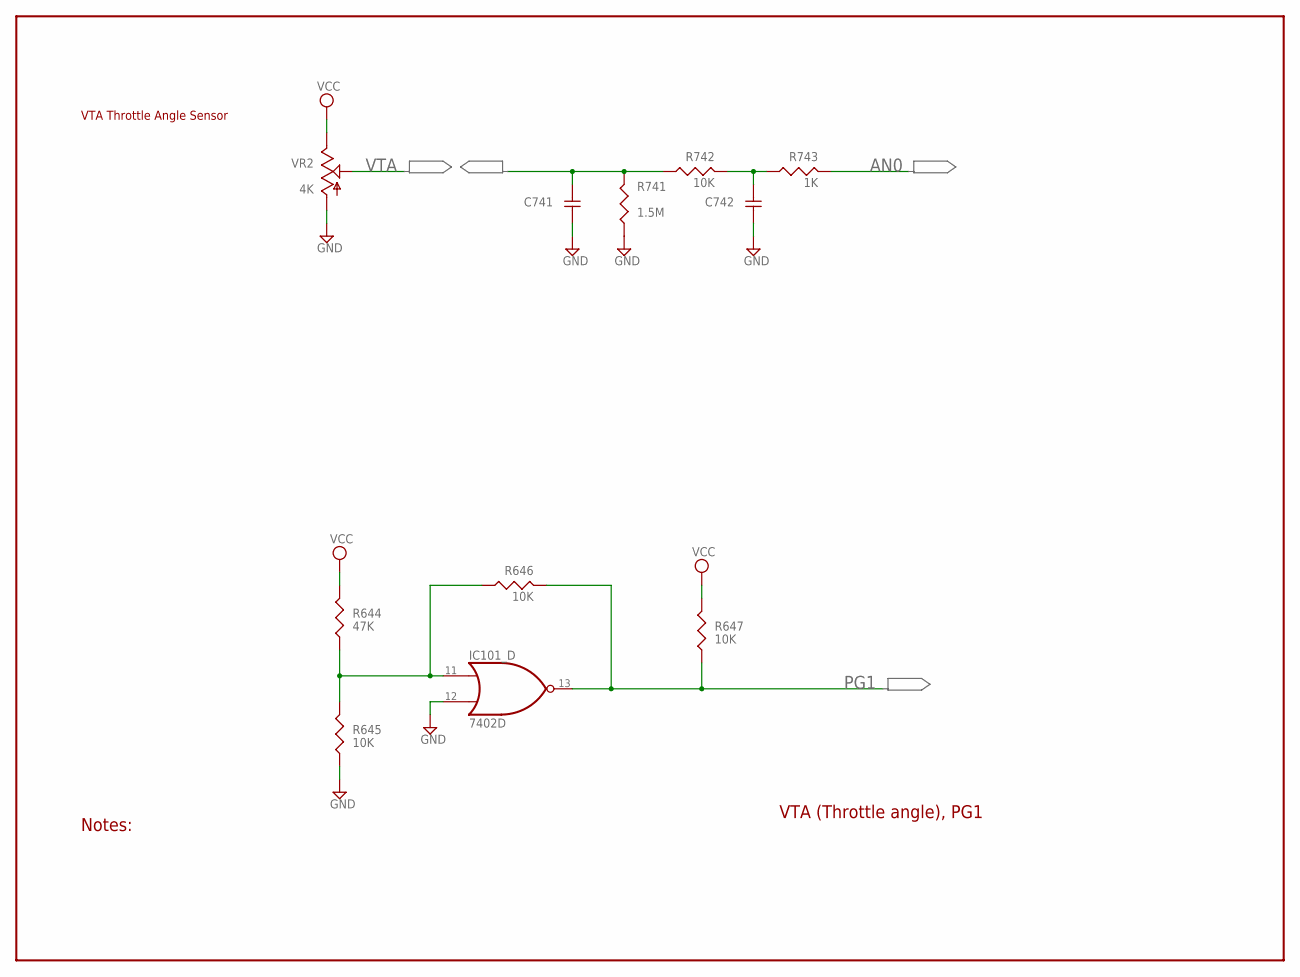
[picture p26: schematic ECU.sch, sheet 11]

Parts:
C741, C742: C-2,5
IC101_: 7402D; SO14
R644: 47K; R-5
R645, R646, R647, R742: 10K; R-5
R741: 1.5M; R-5
R743: 1K; R-5
VR2: 4K; B25V

Connections:
AN0: R743.2
GND: C741.1, C742.1, IC101_.12 (I1), R645.1, R741.1, VR2.A
unnamed: C741.2, R741.2, R742.1
unnamed: C742.2, R742.2, R743.1
unnamed: IC101_.11 (I0), R644.1, R645.2, R646.1
PG1: IC101_.13 (O), R646.2, R647.1
VCC: R644.2, R647.2, VR2.E
VTA: VR2.S

Notes on the sheet:
VTA (Throttle angle), PG1
Notes:
VTA Throttle Angle Sensor

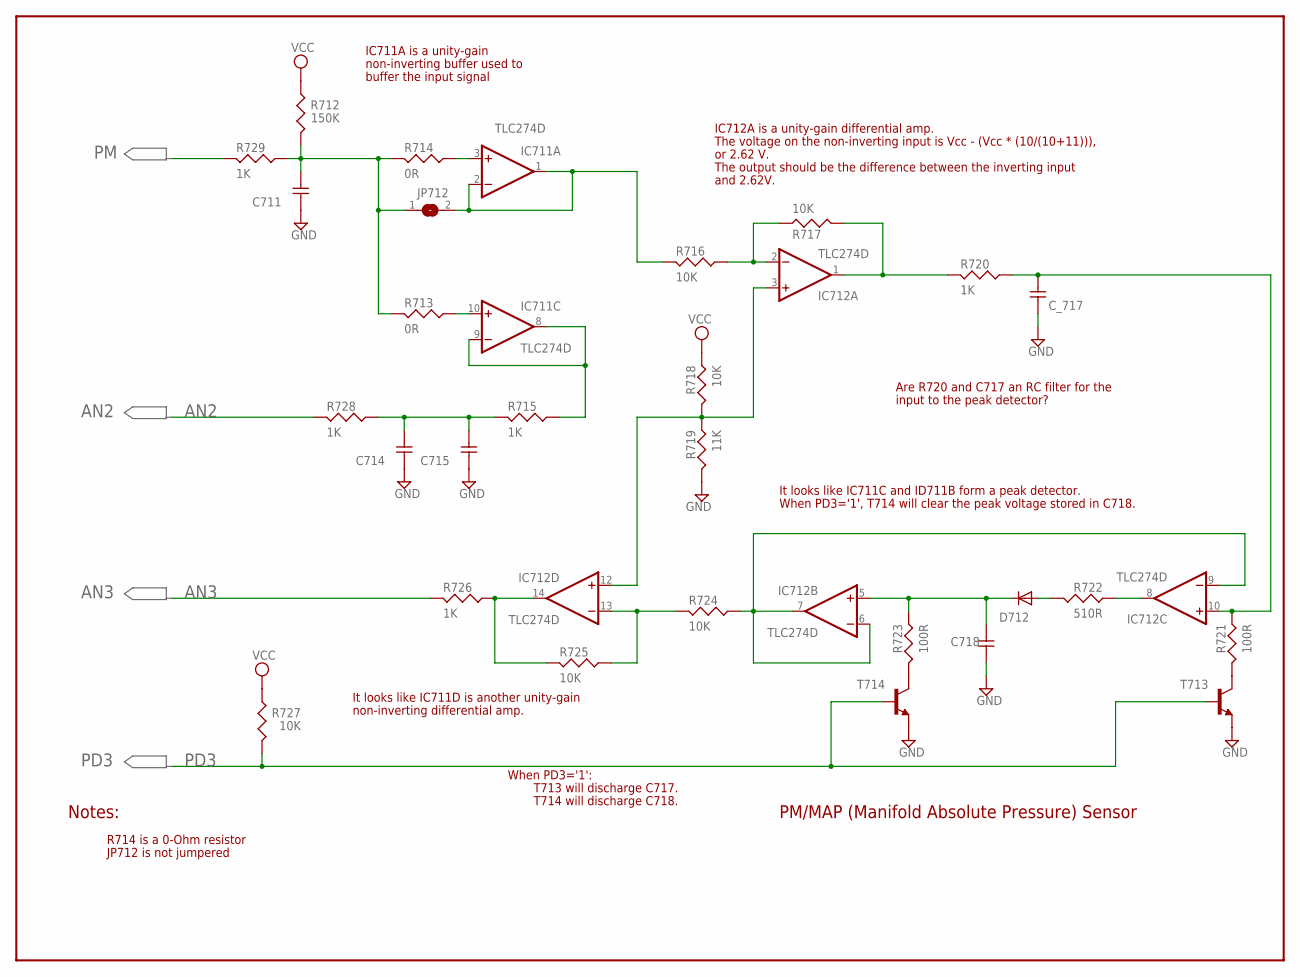
[picture p27: schematic ECU.sch, sheet 12]

Parts:
C711, C714, C715, C718: C-2,5
C_717: C-2,5
D712: 1N4004; DO41-10
IC711, IC712: TLC274D; SO14
JP712: SJ
R712: 150K; R-5
R713, R714: 0R; R-5
R715, R720, R726, R728, R729: 1K; R-5
R716, R717, R718, R724, R725, R727: 10K; R-5
R719: 11K; R-5
R721, R723: 100R; R-5
R722: 510R; R-5
T713, T714: BCF32SMD; SOT23-BEC

Connections:
AN2: R728.2
AN3: R726.2
GND: C711.1, C714.1, C715.1, C718.1, C_717.1, R719.1, T713.E, T714.E
unnamed: R714.2, R729.1
unnamed: C_717.2, IC712.10 (+IN), R720.1, R721.2
unnamed: C711.2, R712.2
unnamed: IC711.10 (+IN), R713.1
unnamed: JP712.1, R713.2
unnamed: IC711.8 (OUT), IC711.9 (-IN)
unnamed: C714.2, C715.2, R715.2, R728.1
unnamed: IC711.3 (+IN), R714.1
unnamed: IC711.1 (OUT), IC711.2 (-IN), JP712.2, R716.2
unnamed: IC712.2 (-IN), R716.1, R717.2
unnamed: IC712.1 (OUT), R717.1, R720.2
unnamed: IC712.14 (OUT), R725.2, R726.1
unnamed: IC712.8 (OUT), R722.2
unnamed: D712.A, R722.1
unnamed: R723.1, T714.C
unnamed: IC712.6 (-IN), IC712.7 (OUT), IC712.9 (-IN), R724.1
unnamed: IC712.13 (-IN), R724.2, R725.1
unnamed: IC712.3 (+IN), IC712.12 (+IN), R718.1, R719.2
unnamed: R721.1, T713.C
PD3: R727.2, T713.B, T714.B
VCC: C718.2, D712.C, IC712.5 (+IN), R712.1, R718.2, R723.2, R727.1

Notes on the sheet:
PM/MAP (Manifold Absolute Pressure) Sensor
Notes:
AN3
PD3
JP712 is not jumpered
R714 is a 0-Ohm resistor
IC711A is a unity-gain
non-inverting buffer used to
buffer the input signal
IC712A is a unity-gain differential amp.
The voltage on the non-inverting input is Vcc - (Vcc * (10/(10+11))),
or 2.62 V.
The output should be the difference between the inverting input
and 2.62V.
It looks like IC711C and ID711B form a peak detector.
When PD3='1', T714 will clear the peak voltage stored in C718.
It looks like IC711D is another unity-gain
non-inverting differential amp.
Are R720 and C717 an RC filter for the
input to the peak detector?
When PD3='1':
T713 will discharge C717.
T714 will discharge C718.
AN2

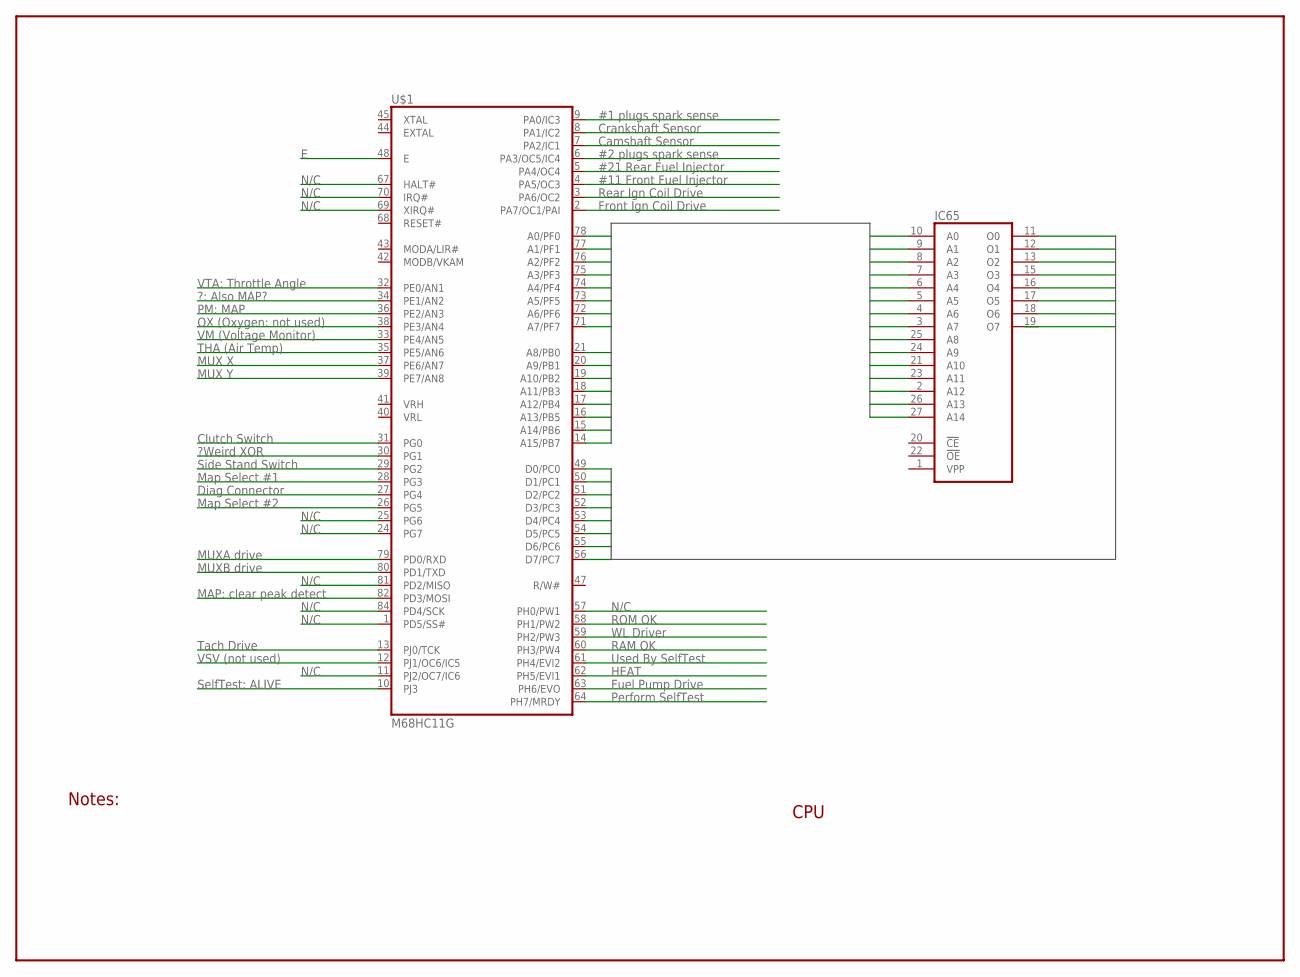
[picture p28: schematic ECU.sch, sheet 13]

Parts:
IC65: 27256; DIL28
U$1: M68HC11G; PLCC84

Connections:
A0: IC65.10 (A0), U$1.78 (A0/PF0)
A1: IC65.9 (A1), U$1.77 (A1/PF1)
A2: IC65.8 (A2), U$1.76 (A2/PF2)
A3: IC65.7 (A3), U$1.75 (A3/PF3)
A4: IC65.6 (A4), U$1.74 (A4/PF4)
A5: IC65.5 (A5), U$1.73 (A5/PF5)
A6: IC65.4 (A6), U$1.72 (A6/PF6)
A7: IC65.3 (A7), U$1.71 (A7/PF7)
A8: IC65.25 (A8), U$1.21 (A8/PB0)
A9: IC65.24 (A9), U$1.20 (A9/PB1)
A10: IC65.21 (A10), U$1.19 (A10/PB2)
A11: IC65.23 (A11), U$1.18 (A11/PB3)
A12: IC65.2 (A12), U$1.17 (A12/PB4)
A13: IC65.26 (A13), U$1.16 (A13/PB5)
A14: IC65.27 (A14), U$1.15 (A14/PB6)
A15: U$1.14 (A15/PB7)
D0: IC65.11 (O0), U$1.49 (D0/PC0)
D1: IC65.12 (O1), U$1.50 (D1/PC1)
D2: IC65.13 (O2), U$1.51 (D2/PC2)
D3: IC65.15 (O3), U$1.52 (D3/PC3)
D4: IC65.16 (O4), U$1.53 (D4/PC4)
D5: IC65.17 (O5), U$1.54 (D5/PC5)
D6: IC65.18 (O6), U$1.55 (D6/PC6)
D7: IC65.19 (O7), U$1.56 (D7/PC7)
E: U$1.48 (E)

Notes on the sheet:
Notes:
CPU
Clutch Switch
?Weird XOR
Side Stand Switch
Map Select #1
Diag Connector
Map Select #2
#1 plugs spark sense
#2 plugs spark sense
Fuel Pump Drive
WL Driver
Tach Drive
VSV (not used)
MUX Y
MUX X
THA (Air Temp)
VM (Voltage Monitor)
OX (Oxygen: not used)
PM: MAP
?: Also MAP?
VTA: Throttle Angle
MAP: clear peak detect
MUXA drive
MUXB drive
N/C
Camshaft Sensor
Crankshaft Sensor
Front Ign Coil Drive
Rear Ign Coil Drive
#11 Front Fuel Injector
#21 Rear Fuel Injector
ROM OK
RAM OK
Used By SelfTest
HEAT
Perform SelfTest
SelfTest: ALIVE
