mookiedog/ApriliaGen1ECU/ECU.sch

## EAGLE design ECU.sch (continued)

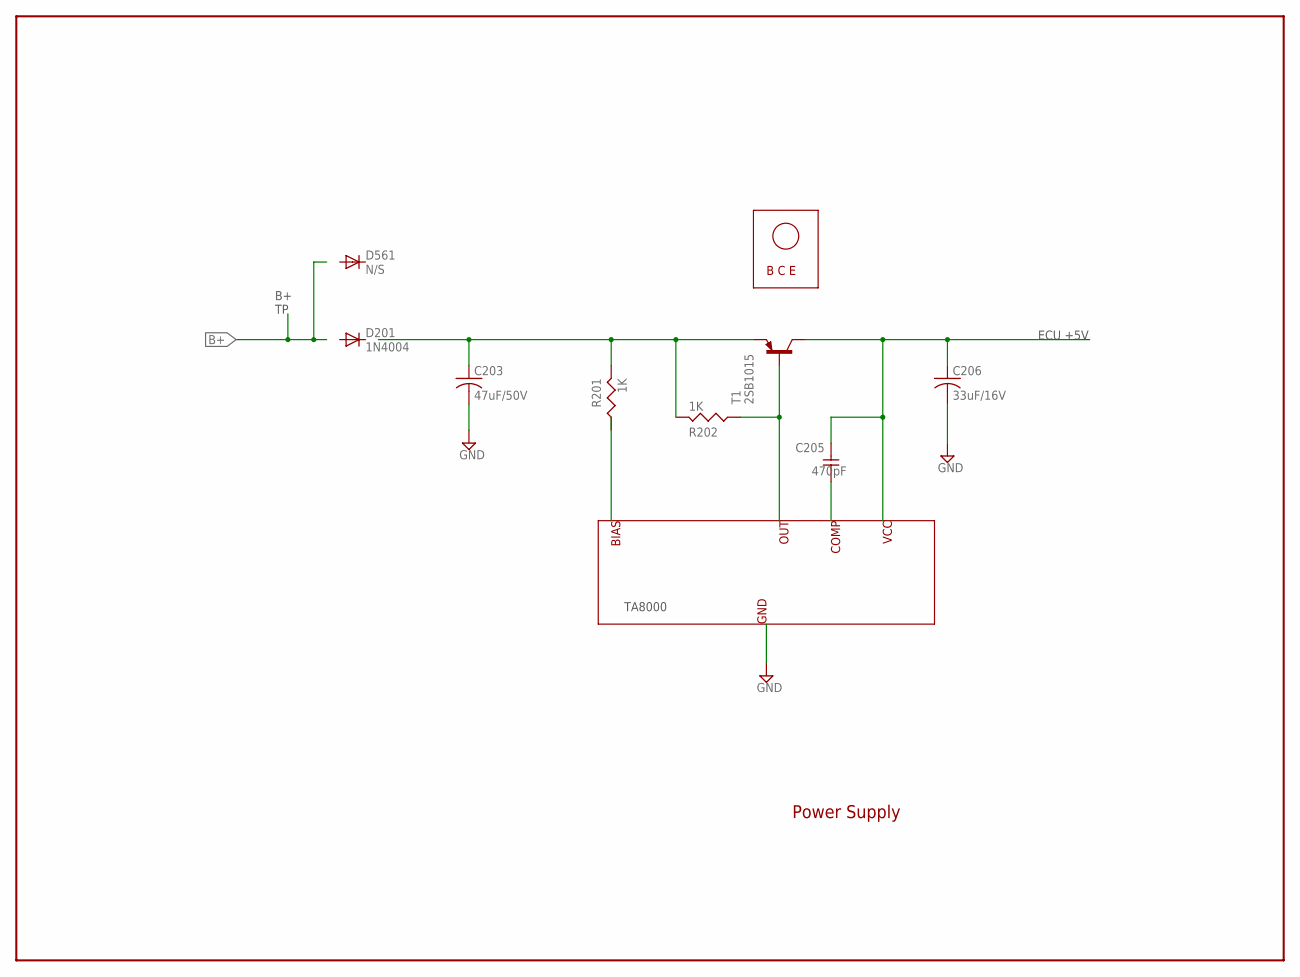
[picture p29: schematic ECU.sch, sheet 14]

Parts:
C203: 47uF/50V; C025-030X050
C205: 470pF; C-2,5
C206: 33uF/16V; C025-030X050
D201: 1N4004; DO41-10
D561: N/S; DO41-10
R201, R202: 1K; R-5
T1: 2SB1015; TO220

Connections:
GND: C203.2, C206.2
unnamed: C203.1, R202.2, T1.3 (E)
unnamed: C205.2, C206.1, T1.2 (C)
unnamed: R202.1, T1.1 (B)

Notes on the sheet:
Power Supply
B+ TP
BIAS
OUT
VCC
COMP
ECU +5V
TA8000
GND
B C E

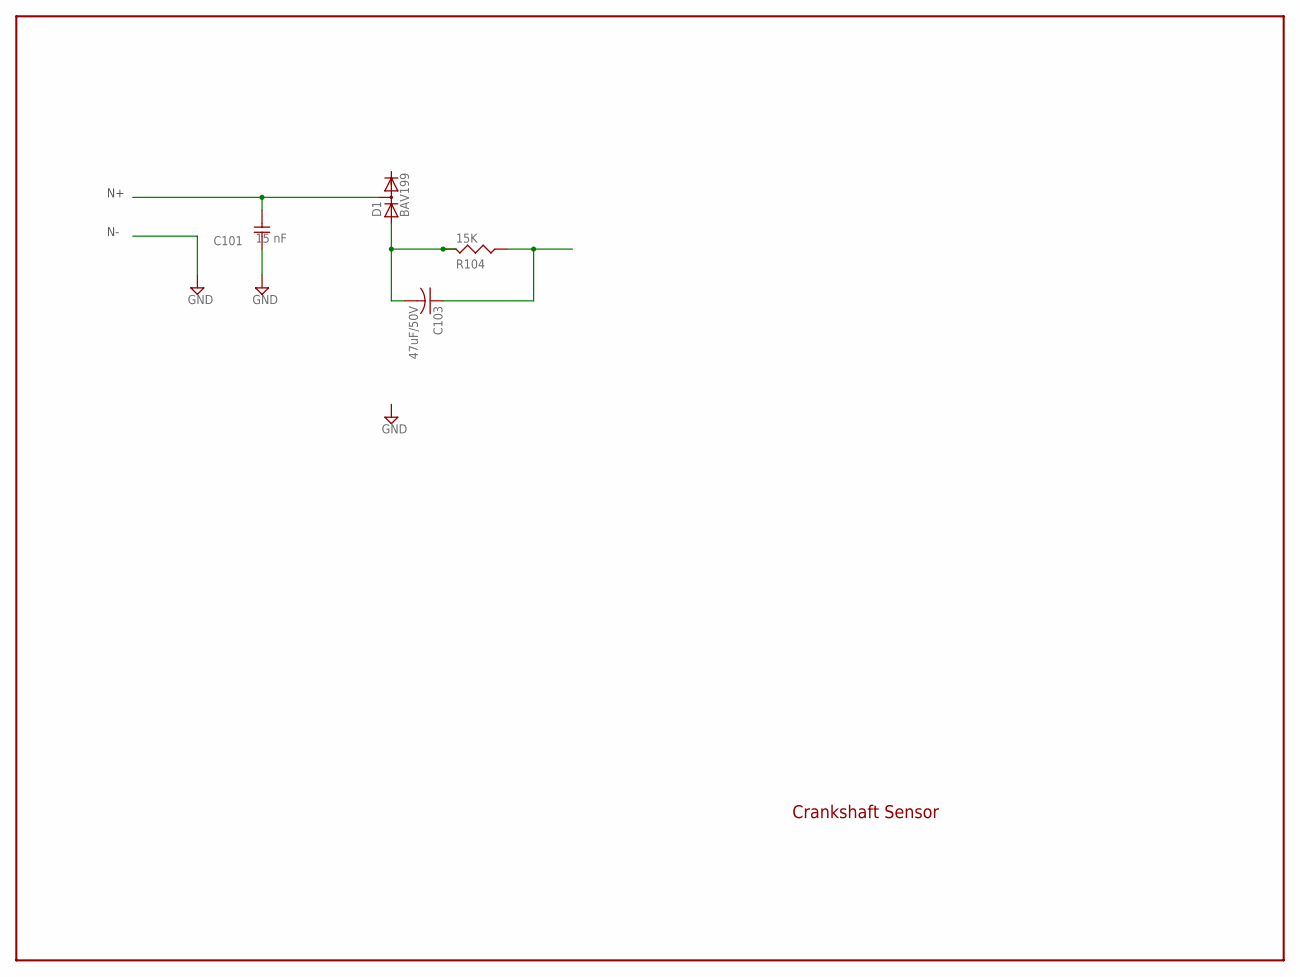
[picture p30: schematic ECU.sch, sheet 15]

Parts:
C101: 15 nF; C-2,5
C103: 47uF/50V; C025-030X050
D1: BAV199; SOT23
R104: 15K; R-5

Connections:
GND: C101.1
unnamed: C103.2, D1.1 (A), R104.2
unnamed: C101.2, D1.3 (AC)
unnamed: C103.1, R104.1

Notes on the sheet:
Crankshaft Sensor
